SolidoodleDev/press-pcbs-and-firmware/Solidoodle Press PCB's/SD5DA - Press Motherboard PCB/readme.txt

Hi Sam, 

   The SD5 was done is Novarm DipTrace. 

Talk soon 

Matt Stevenson 
RUSHdesign LLC
