SolidoodleDev/press-pcbs-and-firmware/Solidoodle Press PCB's/prelim schematics.jpg

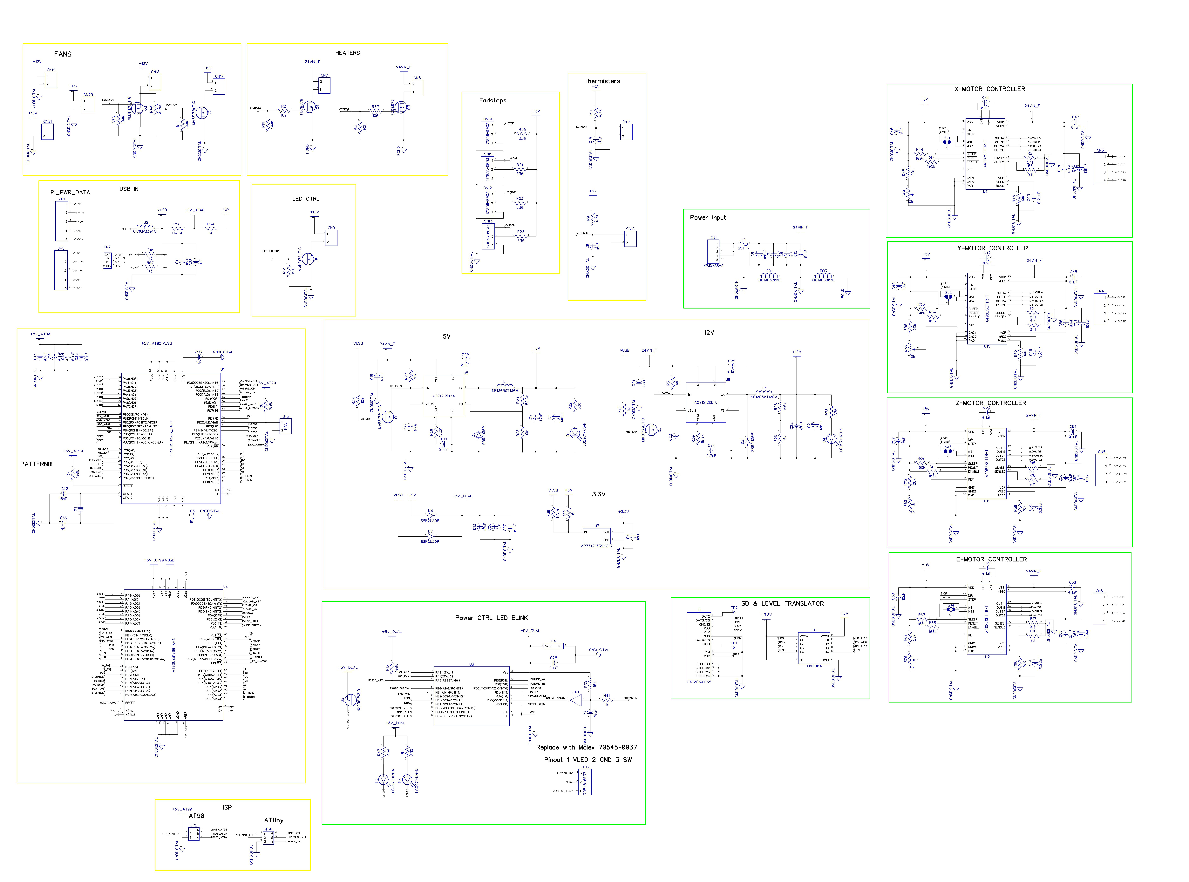
Solidoodle Press PCB's/prelim schematics.jpg
