SolidoodleDev/press-pcbs-and-firmware/Solidoodle Press PCB's/SD5AA - Press Motherboard PCB/image.png

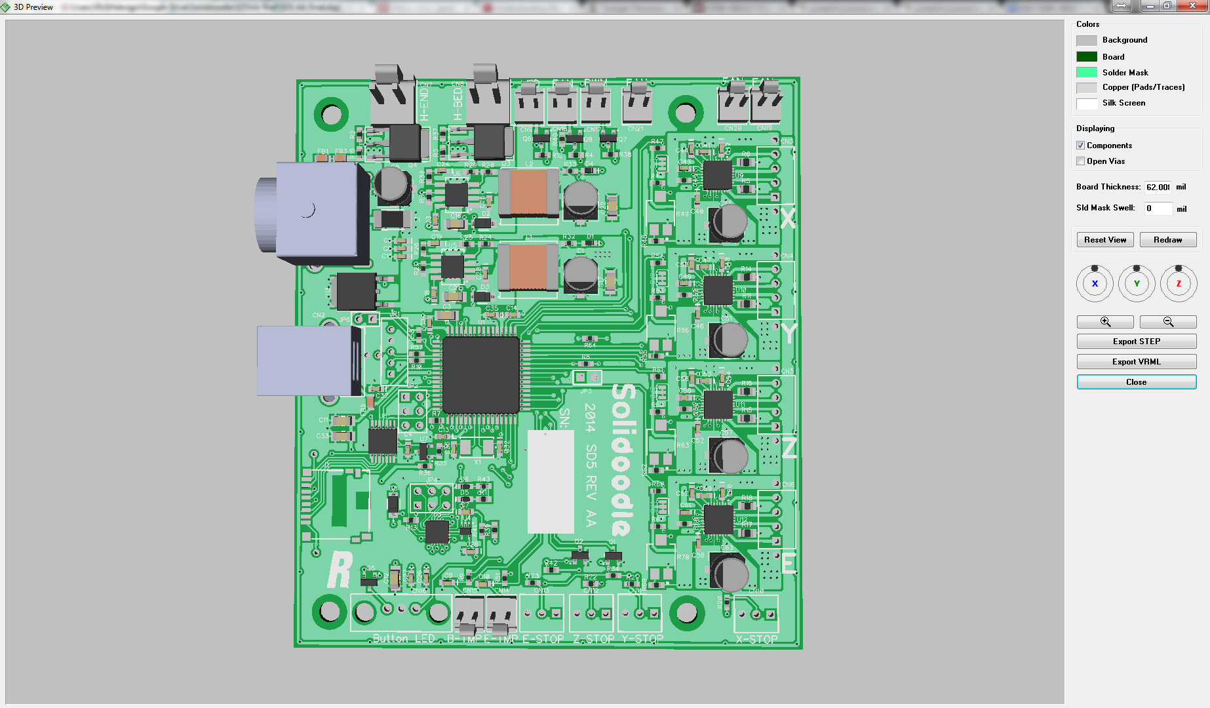
Solidoodle Press PCB's/SD5AA - Press Motherboard PCB/image.png
