SolidoodleDev/press-pcbs-and-firmware/Solidoodle Press PCB's/SD5AA - Press Motherboard PCB/BOM.xls

RefDes | Value | Name | BUILDOPT | Voltage | Tolerance | Circuit
C1 | 100uF | EEE-1VA101XP | 1 |  |  | 5V
C10 | 10uF | CAP_0603 | 1 | 50 | 10.00% | Thermisters
C11 | 10uF | CAP_1206 | 1 | 50 | 10.00% | USB In
C12 | 47uF | CAP_1206 | 1 | 50 | 10.00% | 5V
C13 | 0.1uF | CAP_0603 | 1 | 50 | 10.00% | AT90
C14 | 0.1uF | CAP_0603 | 1 | 50 | 10.00% | AT90
C15 | 0.1uF | CAP_0603 | 1 | 50 | 10.00% | Power input
C16 | 47uF | CAP_1206 | 1 | 50 | 10.00% | 5V
C17 | 47uF | CAP_1206 | 1 | 50 | 10.00% | 5V
C18 | N/A | CAP_0603 | 1 | 50 | 10.00% | 5V
C19 | 2.7nF | CAP_0603 | 1 | 50 | 10.00% | 5V
C2 | 100uF | EEE-1VA101XP | 1 |  |  | 12V
C20 | 0.1uF | CAP_0603 | 1 | 50 | 10.00% | 5V
C21 | 47uF | CAP_1206 | 1 | 50 | 10.00% | 12V
C22 | 47uF | CAP_1206 | 1 | 50 | 10.00% | 12V
C23 | N/A | CAP_0603 | 1 | 50 | 10.00% | 12V
C24 | 2.7nF | CAP_0603 | 1 | 50 | 10.00% | 12V
C25 | 0.1uF | CAP_0603 | 1 | 50 | 10.00% | 12V
C26 | 1uF | CAP_0603 | 1 | 50 | 10.00% | 5V
C27 | 0.1uF | CAP_0603 | 1 | 50 | 10.00% | 5V
C28 | 0.1uF | CAP_0603 | 1 | 50 | 10.00% | Button
C3 | 1uF | CAP_1206 | 1 | 50 | 10.00% | AT90
C32 | 15pF | 06031A150JAT2A | 1 |  |  | AT90
C33 | 1uF | CAP_1206 | 1 | 50 | 10.00% | USB in
C34 | 0.1uF | CAP_0603 | 1 | 50 | 10.00% | AT90
C35 | 0.1uF | CAP_0603 | 1 | 50 | 10.00% | AT90
C36 | 15pF | 06031A150JAT2A | 1 |  |  | AT90
C37 | 1uF | CAP_0603 | 1 | 50 | 10.00% | AT90
C4 | 10uF | CAP_0603 | 3 | 50 | 10.00% | 3.3V
C40 | 10uF | CAP_0603 | 1 | 50 | 10.00% | X motor
C41 | 0.1uF | CAP_0603 | 1 | 50 | 10.00% | X motor
C42 | 0.1uF | CAP_0603 | 1 | 50 | 10.00% | X motor
C43 | 0.22uF | CAP_0603 | 1 | 50 | 10.00% | X motor
C44 | 0.1uF | CAP_0603 | 1 | 50 | 10.00% | X motor
C45 | 100uF | EEE-1VA101XP | 1 |  |  | X motor
C46 | 10uF | CAP_0603 | 1 | 50 | 10.00% | Y motor
C47 | 0.1uF | CAP_0603 | 1 | 50 | 10.00% | Y motor
C48 | 0.1uF | CAP_0603 | 1 | 50 | 10.00% | Y motor
C49 | 0.22uF | CAP_0603 | 1 | 50 | 10.00% | Y motor
C5 | 100uF | EEE-1VA101XP | 1 |  |  | Power input
C50 | 0.1uF | CAP_0603 | 1 | 50 | 10.00% | Y motor
C51 | 100uF | EEE-1VA101XP | 1 |  |  | Y motor
C52 | 10uF | CAP_0603 | 1 | 50 | 10.00% | Z motor
C53 | 0.1uF | CAP_0603 | 1 | 50 | 10.00% | Z motor
C54 | 0.1uF | CAP_0603 | 1 | 50 | 10.00% | Z motor
C55 | 0.22uF | CAP_0603 | 1 | 50 | 10.00% | Z motor
C56 | 0.1uF | CAP_0603 | 1 | 50 | 10.00% | Z motor
C57 | 100uF | EEE-1VA101XP | 1 |  |  | Z motor
C58 | 10uF | CAP_0603 | 1 | 50 | 10.00% | E motor
C59 | 0.1uF | CAP_0603 | 1 | 50 | 10.00% | E motor
C6 | 10uF | CAP_0603 | 1 | 50 | 10.00% | Power input
C60 | 0.1uF | CAP_0603 | 1 | 50 | 10.00% | E motor
C61 | 0.22uF | CAP_0603 | 1 | 50 | 10.00% | E motor
C62 | 0.1uF | CAP_0603 | 1 | 50 | 10.00% | E motor
C63 | 100uF | EEE-1VA101XP | 1 |  |  | E motor
C7 | 10uF | CAP_0603 | 1 | 50 | 10.00% | Button
C8 | 1uF | CAP_0603 | 1 | 50 | 10.00% | Power input
C9 | 10uF | CAP_0603 | 1 | 50 | 10.00% | Thermisters
CN1 | KPJX-3S-S | KPJX-3S/ KPJX-4S | 1 |  |  | Power input
CN10 | 171856-0003 | 1X3 0.1in Friction Lock | 1 |  |  | Endstops
CN11 | 171856-0003 | 1X3 0.1in Friction Lock | 1 |  |  | Endstops
CN12 | 171856-0003 | 1X3 0.1in Friction Lock | 1 |  |  | Endstops
CN13 | 171856-0003 | 1X3 0.1in Friction Lock | 1 |  |  | Endstops
CN14 | 171856-0002 | 1X2 0.1in Friction Lock | 1 |  |  | Thermisters
CN15 | 171856-0002 | 1X2 0.1in Friction Lock | 1 |  |  | Thermisters
CN16 | 70545-0037 | 1X3 0.1in Friction Lock | 1 |  |  | Button
CN17 | 171856-0002 | 1X2 0.1in Friction Lock | 1 |  |  | Fans
CN18 | 171856-0002 | 1X2 0.1in Friction Lock | 1 |  |  | Fans
CN19 | 171856-0002 | 1X2 0.1in Friction Lock | 1 |  |  | Fans
CN2 | AU-Y1007-R | USB-B-TH | 1.3 |  |  | USB in
CN20 | 171856-0002 | 1X2 0.1in Friction Lock | 1 |  |  | Fans
CN21 | 171856-0002 | 1X2 0.1in Friction Lock | 1 |  |  | Fans
CN3 | 71856-0004 | 1X4 0.1in Friction Lock | 1 |  |  | X motor
CN4 | 71856-0004 | 1X4 0.1in Friction Lock | 1 |  |  | Y motor
CN5 | 71856-0004 | 1X4 0.1in Friction Lock | 1 |  |  | Z motor
CN6 | 71856-0004 | 1X4 0.1in Friction Lock | 1 |  |  | E motor
CN7 | 640445-2 | 2PIN HEADER 0.156 | 1 |  |  | Heaters
CN8 | 640445-2 | 2PIN HEADER 0.156 | 1 |  |  | Heaters
CN9 | 171856-0002 | 1X2 0.1in Friction Lock | 1 |  |  | LED ctrl
D1 | LGQ971-KN-N | LED | 1 |  |  | 5V
D2 | SBR2U30P1 | SBR2U30P1 | 1 |  |  | 12V
D3 | SBR2U30P1 | SBR2U30P1 | 1 |  |  | 5V
D4 | LGQ971-KN-N | LED | 1 |  |  | 12V
D5 | LGQ971-KN-N | LED | 1 |  |  | Button
D6 | LGQ971-KN-N | LED | 1 |  |  | Button
D8 | SBR2U30P1 | SBR2U30P1 | 1 |  |  | 5V
F1 | SST 7 | FUSE | 1 |  |  | Power input
FB1 | CIS21P300NE | IND_0805 | 1 | 50 |  | Power input
FB2 | CIS21P300NE | IND_0805 | 1 | 50 |  | USB in
FB3 | CIS21P300NE | IND_0805 | 1 | 50 |  | Power input
J1 | 114-00841-68 | MICROSD | 3 |  |  | SD card
J2 | 440054-5 | CC1X5M 2MM | 1 |  |  | AT90
J3 | 440054-5 | CC1X5M 2MM | 1 |  |  | AT90
J4 | 440054-3 | CC1X3M 2MM | 1 |  |  | AT90
JP1 | 440054-5 | CC1X5M 2MM | 1 |  |  | USB in
JP2 | 67998-406HLF | 2x3 .100in | 1 |  |  | ISP
JP3 | 68602-402HLF | BOOT | 1 |  |  | AT90
JP4 | 67998-406HLF | 2x3 .100in | 1 |  |  | ISP
JP6 | 68602-402HLF |  | 1.3 |  |  | USB in
JP7 | 440054-5 | CC1X5M 2MM | 1.4 |  |  | AT90
L1 | NR10050T100M | Yaiyo Yuden 10050 | 1 |  |  | 5V
L2 | NR10050T100M | Yaiyo Yuden 10050 | 1 |  |  | 12V
Q1 | MMBF170LT1G | MOSFETN | 1 |  |  | 5V
Q2 | MMBF170LT1G | MOSFETN | 1 |  |  | 12V
Q3 | FDD8876 | MOSFET-N TO-252 | 1 |  |  | Heaters
Q4 | FDD8876 | MOSFET-N TO-252 | 1 |  |  | Heaters
Q5 | NX2301P,215 | MOSFETN | 1 |  |  | Button
Q6 | MMBF170LT1G | MOSFETN | 1 |  |  | LED ctrl
Q7 | MMBF170LT1G | MOSFETN | 1 |  |  | Fans
Q8 | MMBF170LT1G | MOSFETN | 1.5 |  |  | Fans
R1 | 330 | RES_0603 | 1 | 50 | 5.00% | Button
R10 | 22 | RES_0603 | 1 | 50 | 5.00% | USB in
R11 | 0.11 | RES_0805 | 1 | 50 | 1.00% | Y motor
R12 | 100K | RES_0603 | 1 | 50 | 5.00% | LED ctrl
R13 | 100k | RES_0603 | 1 | 50 | 5.00% | Button
R14 | 0.11 | RES_0805 | 1 | 50 | 1.00% | Y motor
R15 | 0.11 | RES_0805 | 1 | 50 | 1.00% | Z motor
R16 | 0.11 | RES_0805 | 1 | 50 | 1.00% | Z motor
R17 | 0.11 | RES_0805 | 1 | 50 | 1.00% | E motor
R18 | 0.11 | RES_0805 | 1 | 50 | 1.00% | E motor
R19 | 100K | RES_0603 | 1 | 50 | 5.00% | Heaters
R2 | 100 | RES_0603 | 1 | 50 | 5.00% | Heaters
R20 | 330 | RES_0603 | 1 | 50 | 5.00% | Endstops
R21 | 330 | RES_0603 | 1 | 50 | 5.00% | Endstops
R22 | 330 | RES_0603 | 1 | 50 | 5.00% | Endstops
R23 | 330 | RES_0603 | 1 | 50 | 5.00% | Endstops
R24 | 52.3k | RES_0603 | 1 | 50 | 5.00% | 5V
R25 | 10k | RES_0603 | 1 | 50 | 5.00% | 5V
R26 | 18.2K | RES_0603 | 1 | 50 | 5.00% | 5V
R27 | 10k | RES_0603 | 1 | 50 | 5.00% | 5V
R28 | 140k | RES_0603 | 1 | 50 | 5.00% | 12V
R29 | 10k | RES_0603 | 1 | 50 | 5.00% | 12V
R3 | 100K | RES_0603 | 1 | 50 | 5.00% | Heaters
R30 | 18.2k | RES_0603 | 1 | 50 | 5.00% | 12V
R31 | 10k | RES_0603 | 1 | 50 | 5.00% | 12V
R32 | 330 | RES_0603 | 1 | 50 | 5.00% | 5V
R33 | 330 | RES_0603 | 1 | 50 | 5.00% | 12V
R34 | 10k | RES_0603 | 1 | 50 | 5.00% | 5V
R35 | 0 | RES_0603 | 3 | 50 | 5.00% | 3.3V
R36 | NA 0 | RES_0603 | 3 | 50 | 5.00% | 3.3V
R37 | 100 | RES_0603 | 1 | 50 | 5.00% | Heaters
R38 | 100K | RES_0603 | 1.5 | 50 | 5.00% | Fans
R39 | 10K | RES_0603 | 1 | 50 | 5.00% | Button
R4 | 100K | RES_0603 | 1 | 50 | 5.00% | Fans
R40 | 0 NA | RES_0603 | 1.6 | 50 | 5.00% | Fans
R41 | 1k | RES_0603 | 1 | 50 | 5.00% | Button
R42 | 10k | RES_0603 | 1 | 50 | 5.00% | 12V
R43 | 330 | RES_0603 | 1 | 50 | 5.00% | Button
R44 | 0/DNP | RES_0603 | 0 | 50 | 5.00% | Button
R45 | 10K | RES_0603 | 1 | 50 | 1.00% | X motor
R46 | 100k | RES_0603 | 1 | 50 | 5.00% | X motor
R47 | 100k | RES_0603 | 1 | 50 | 5.00% | X motor
R48 | 20k | RES_0603 | 1 | 50 | 5.00% | X motor
R49 | 10k | ST-4ETB | 1 |  |  | X motor
R5 | 0.11 | RES_0805 | 1 | 50 | 1.00% | X motor
R50 | 0/DNP | RES_0603 | 0 | 50 | 5.00% | Button
R51 | 4.7K | RES_0603 | 1 | 50 | 5.00% | Thermisters
R52 | 10K | RES_0603 | 1 | 50 | 1.00% | Y motor
R53 | 100k | RES_0603 | 1 | 50 | 5.00% | Y motor
R54 | 100k | RES_0603 | 1 | 50 | 5.00% | Y motor
R55 | 20k | RES_0603 | 1 | 50 | 5.00% | Y motor
R56 | 10k | ST-4ETB | 1 |  |  | Y motor
R57 | 22 | RES_0603 | 1 | 50 | 5.00% | USB in
R58 | NA 0 | RES_0603 | 1.4 | 50 | 5.00% | USB in
R59 | 10K | RES_0603 | 1 | 50 | 1.00% | Z motor
R6 | 0.11 | RES_0805 | 1 | 50 | 1.00% | X motor
R60 | 100k | RES_0603 | 1 | 50 | 5.00% | Z motor
R61 | 100k | RES_0603 | 1 | 50 | 5.00% | Z motor
R62 | 20k | RES_0603 | 1 | 50 | 5.00% | Z motor
R63 | 10k | ST-4ETB | 1 |  |  | Z motor
R64 | 0 | RES_0603 | 1 | 50 | 5.00% | USB in
R66 | 10K | RES_0603 | 1 | 50 | 1.00% | E motor
R67 | 100k | RES_0603 | 1 | 50 | 5.00% | E motor
R68 | 100k | RES_0603 | 1 | 50 | 5.00% | E motor
R69 | 20k | RES_0603 | 1 | 50 | 5.00% | E motor
R7 | 100k | RES_0603 | 1 | 50 | 5.00% | AT90
R70 | 10k | ST-4ETB | 1 |  |  | E motor
R8 | 100k | RES_0603 | 1 | 50 | 5.00% | AT90
R9 | 4.7K | RES_0603 | 1 | 50 | 5.00% | Thermisters
SJ1 |  | SOLDERJUMPER_2WAYCONNECTED | 1 |  |  | X motor
SJ2 |  | SOLDERJUMPER_2WAYCONNECTED | 1 |  |  | Y motor
SJ3 |  | SOLDERJUMPER_2WAYCONNECTED | 1 |  |  | Z motor
SJ4 |  | SOLDERJUMPER_2WAYCONNECTED | 1 |  |  | E motor
TP1 |  | TESTPOINT |  |  |  | SD card
TP2 |  | TESTPOINT |  |  |  | SD card
U1 | AT90USB1286 | AT90USB1286_TQFP | 1.1 |  |  | AT90
U10 | A4982SETTR-T | A4982SETTR-T | 1 |  |  | Y motor
U11 | A4982SETTR-T | A4982SETTR-T | 1 |  |  | Z motor
U12 | A4982SETTR-T | A4982SETTR-T | 1 |  |  | E motor
U13 | L78M05CDT-TR | L78M05CDT-TR | 1 |  |  | 5V
U2 | AT90USB1286 | AT90USB1286_QFN | 1.2 |  |  | AT90
U3 | ATTINY2313A-MUR | ATTINY2313_MLF | 1 |  |  | Button
U4 |  | MC74VHC1G14DFT1 | 1 |  |  | Button
U5 | AOZ1212DI/AI | AOZ1212DI/AI | 1 |  |  | 5V
U6 | AOZ1212DI/AI | AOZ1212DI/AI | 1 |  |  | 12V
U7 | AP7313-33SAG-7 | AP7313 | 3 |  |  | 3.3V
U8 | TXB0104 | TXB0104 | 3 |  |  | SD card
U9 | A4982SETTR-T | A4982SETTR-T | 1 |  |  | X motor
X1 | ABM3-16.000MHZ-D2Y-T | ABM3 | 1 |  |  | AT90
