SolidoodleDev/press-pcbs-and-firmware/Solidoodle Press PCB's/SD5BA - Press Motherboard PCB/BUILD BOM BA.xls

Sheet: POP
RefDes | Name | Value | Voltage/Watt | TOL | BUILDOPT | Notes
R35 | RES_0603 | 0 | 1/4W | 1.00% | 3
R64 | RES_0603 | 0 | 1/4W | 1.00% | 1
R11 | RES_0805 | 0.11 | 1/4W | 1.00% | 1
R14 | RES_0805 | 0.11 | 1/4W | 1.00% | 1
R15 | RES_0805 | 0.11 | 1/4W | 1.00% | 1
R16 | RES_0805 | 0.11 | 1/4W | 1.00% | 1
R17 | RES_0805 | 0.11 | 1/4W | 1.00% | 1
R18 | RES_0805 | 0.11 | 1/4W | 1.00% | 1
R5 | RES_0805 | 0.11 | 1/4W | 1.00% | 1
R6 | RES_0805 | 0.11 | 1/4W | 1.00% | 1
R10 | RES_0603 | 22 | 1/8W | 1.00% | 1
R57 | RES_0603 | 22 | 1/8W | 1.00% | 1
R2 | RES_0603 | 100 | 1/8W | 1.00% | 1
R37 | RES_0603 | 100 | 1/8W | 1.00% | 1
R1 | RES_0603 | 330 | 1/8W | 1.00% | 1
R20 | RES_0603 | 330 | 1/8W | 1.00% | 1
R21 | RES_0603 | 330 | 1/8W | 1.00% | 1
R22 | RES_0603 | 330 | 1/8W | 1.00% | 1
R23 | RES_0603 | 330 | 1/8W | 1.00% | 1
R32 | RES_0603 | 330 | 1/8W | 1.00% | 1
R43 | RES_0603 | 330 | 1/8W | 1.00% | 1
R33 | RES_0603 | 420 | 1/8W | 1.00% | 1
C13 | CAP_0603 | 0.1uF | 50V | 10.00% | 1
C14 | CAP_0603 | 0.1uF | 50V | 10.00% | 1
C15 | CAP_0603 | 0.1uF | 50V | 10.00% | 1
C20 | CAP_0603 | 0.1uF | 50V | 10.00% | 1
C25 | CAP_0603 | 0.1uF | 50V | 10.00% | 1
C27 | CAP_0603 | 0.1uF | 50V | 10.00% | 1
C28 | CAP_0603 | 0.1uF | 50V | 10.00% | 1
C34 | CAP_0603 | 0.1uF | 50V | 10.00% | 1
C35 | CAP_0603 | 0.1uF | 50V | 10.00% | 1
C41 | CAP_0603 | 0.1uF | 50V | 10.00% | 1
C42 | CAP_0603 | 0.1uF | 50V | 10.00% | 1
C44 | CAP_0603 | 0.1uF | 50V | 10.00% | 1
C47 | CAP_0603 | 0.1uF | 50V | 10.00% | 1
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
JP4 | 2x3 .100in | 67998-406HLF |  |  | 1
JP6 | 68602-402HLF | 68602-402HLF |  |  | 1.3
JP3 | BOOT | 68602-402HLF |  |  | 1
CN16 | 1X3 0.1in Friction Lock | 70545-0037 |  |  | 1
CN3 | 1X4 0.1in Friction Lock | 71856-0004 |  |  | 1
CN4 | 1X4 0.1in Friction Lock | 71856-0004 |  |  | 1
CN5 | 1X4 0.1in Friction Lock | 71856-0004 |  |  | 1
CN6 | 1X4 0.1in Friction Lock | 71856-0004 |  |  | 1
U10 | A4982SETTR-T | A4982SETTR-T |  |  | 1
U11 | A4982SETTR-T | A4982SETTR-T |  |  | 1
U12 | A4982SETTR-T | A4982SETTR-T |  |  | 1
U9 | A4982SETTR-T | A4982SETTR-T |  |  | 1
X1 | ABM3-16.000MHZ-D2Y-T | ABM3-16.000MHZ-D2Y-T |  |  | 1
U5 | AOZ1212DI/AI | AOZ1212DI/AI |  |  | 1
U6 | AOZ1212DI/AI | AOZ1212DI/AI |  |  | 1
U7 | AP7313-33SAG-7 | AP7313-33SAG-7 |  |  | 3
U2 | AT90USB1286-MU | AT90USB1286-MU |  |  | 1.2
U14 | ATTINY2313_SOIC | ATTINY2313A-MUR |  |  | 1
CN2 | USB-B-TH | AU-Y1007-R |  |  | 1.3
FB1 | IND_0805 | CIS21P300NE |  |  | 1
FB2 | IND_0805 | CIS21P300NE |  |  | 1
FB3 | IND_0805 | CIS21P300NE |  |  | 1
Q3 | MOSFET-N TO-252 | FDD8876 |  |  | 1
Q4 | MOSFET-N TO-252 | FDD8876 |  |  | 1
CN1 | KPJX-3S/ KPJX-4S | KPJX-3S-S |  |  | 1
U13 | L78M05CDT-TR | L78M05CDT-TR |  |  | 1
D1 | LED | LGQ971-KN-N |  |  | 1
D4 | LED | LGQ971-KN-N |  |  | 1
D5 | LED | LGQ971-KN-N |  |  | 1
D6 | LED | LGQ971-KN-N |  |  | 1
U4 | MC74VHC1G14DFT1 | MC74VHC1G14DFT1 |  |  | 1
Q1 | MOSFETN | MMBF170LT1G |  |  | 1
Q2 | MOSFETN | MMBF170LT1G |  |  | 1
Q6 | MOSFETN | MMBF170LT1G |  |  | 1
Q7 | MOSFETN | MMBF170LT1G |  |  | 1
Q8 | MOSFETN | MMBF170LT1G |  |  | 1.5
L1 | Yaiyo Yuden 10050 | NR10050T100M |  |  | 1
L2 | Yaiyo Yuden 10050 | NR10050T100M |  |  | 1
Q5 | MOSFETN | NX2301P,215 |  |  | 1
D2 | SBR2U30P1 | SBR2U30P1 |  |  | 1
D3 | SBR2U30P1 | SBR2U30P1 |  |  | 1
D8 | SBR2U30P1 | SBR2U30P1 |  |  | 1
F1 | FUSE | SST 7 |  |  | 1
J1 | TF Outside welding | TF Outside welding |  |  | 3 | No part number provided by OEM
U8 | TXB0104 | TXB0104 |  |  | 3
R49 | ST4ETB 10K |  |  |  | 1
R56 | ST4ETB 10K |  |  |  | 1
R63 | ST4ETB 10K |  |  |  | 1
R70 | ST4ETB 10K |  |  |  | 1

Sheet: DNP
RefDes | Name | Part | Value | BUILDOPT | Pattern | Notes
J2 | CC1X5M 2MM | Part 1 | 440054-5 | 4 | 440054-5
J3 | CC1X5M 2MM | Part 1 | 440054-5 | 4 | 440054-5
J4 | CC1X3M 2MM | Part 1 | 440054-3 | 4 | 440054-31x3
JP1 | CC1X5M 2MM | Part 1 | 440054-5 | 4 | 440054-5
JP7 | CC1X5M 2MM | Part 1 | 440054-5 | 5 | 440054-5
R36 | RES_0603 | Part 1 | NA 0 | 5 | RES_0603
R40 | RES_0603 | Part 1 | 0 NA | 5 | RES_0603
R44 | RES_0603 | Part 1 | 0/DNP | 5 | RES_0603 | On BA Silk Swapped with R13
R50 | RES_0603 | Part 1 | 0/DNP | 5 | RES_0603
R58 | RES_0603 | Part 1 | NA 0 | 5 | RES_0603
U3 | ATTINY2313_MLF | Part 1 | ATTINY2313A-MUR | 5 | QFN-20/4x4x0.5
U1 | AT90USB1286_TQFP | Part 1 | AT90USB1286 | 6 | QFP-64/16x16x0.8
SJ1 | SOLDERJUMPER_2WAYCONNECTED | Part 1 |  |  |  | 1 | SJ_3_CONNECTED
SJ2 | SOLDERJUMPER_2WAYCONNECTED | Part 1 |  |  |  | 1 | SJ_3_CONNECTED
SJ3 | SOLDERJUMPER_2WAYCONNECTED | Part 1 |  |  |  | 1 | SJ_3_CONNECTED
SJ4 | SOLDERJUMPER_2WAYCONNECTED | Part 1 |  |  |  | 1 | SJ_3_CONNECTED
