SolidoodleDev/press-pcbs-and-firmware/Solidoodle Press PCB's/SD5BA - Press Motherboard PCB/MOTHERBOARD BOM-20131224.xls

AMI P/N | MFG | MFG P/N | QTY | REF DES
PRINTBOARD-PC | PCB,6 UP,LEADED ENIG | 1 | 1 | BOARD
Mfgrs: | IMAGINEERING(LF) | [PRINTBOARD-PC](LF)
SOL-00065-000 | CAP,15PF,0603 | 2 | 2 | C38,C39
Mfgrs: | AVX(LF) | [06031A150JAT2A](LF)
 | JARO(LF) | [CC0603CG150JT100PR](
 | MOUSER(LF) | [581-06031A150J](LF)
SOL-00041-000 | IND,POWER 47UH 1.25A SMD | 1 | 1 | L1
Mfgrs: | BOURNS(LF) | [SDR1006-470KL](LF)
SOL-00036-000 | CAP,ALUM,100uF 20%,35V,SMD | 5 | 5 | C6,C7,C16,C18,C23
Mfgrs: | PANASONIC(LF) | [EEE-1VA101XP](LF)
SOL-00060-000 | IC,VLT LVL TRNSLT,14TSSOP | 1 | 1 | U8
Mfgrs: | T.I(LF) | [TXB0104PWR](LF)
SOL-00064-000 | xtal,16MHz 18pF 30ppm -40C | +85 1 | 1 | X1
Mfgrs: | ABRACON(LF) | [ABM3-16.000MHZ-D2Y-T
 | MOUSER(LF) | [815-ABM3-16-D2Y-T](L
SOL-00048-000 | RES 5.6K 1/8W 5% 0805 | 1 | 1 | R37
Mfgrs: | PANASONIC(LF) | [ERJ-6GEYJ562V](LF)
SOL-00057-000 | IC,DRV,MTRSTEP,24-TSSOP | 4 | 4 | U2,U3,U4,U5
Mfgrs: | ALLEGRO(LF) | [A4982SLPTR-T](LF)
SOL-00037-000 | DIO,40V 1A,SMA | 1 | 1 | D1
Mfgrs: | DIODES INC(LF) | [B140-13-F](LF)
SOL-00050-000 | POT,TRIM,10K OHM 0.25W SMD | 4 | 4 | R5,R15,R23,R29
Mfgrs: | BOURNS(LF) | [3314G-1-103E](LF)
SOL-00046-000 | RES 1.0K 1/8W 5% 0805 | 1 | 1 | R38
Mfgrs: | PANASONIC(LF) | [ERJ-6GEYJ102V](LF)
SOL-00033-000 | CAP,1UF,10%,16V,X7R,0805 | 2 | 2 | C11,C12
Mfgrs: | MURATA(LF) | [GRM21BR71C105KA01L](
SOL-00052-000 | RES 22 OHM 1/8W 5% 0805 | 2 | 2 | R7,R8
Mfgrs: | PANASONIC(LF) | [ERJ-6GEYJ220V](LF)
SOL-00045-000 | RES,0.1 OHM,1%,1/8W,0805 | 8 | 8 | R16,R17,R18,R19,R24,R25,R30,R31
Mfgrs: | BOURNS(LF) | [CRL0805-FW-R100ELF](
SOL-00031-000 | CAP,0.1UF,10%,25V,X7R,0805 | 17 | 17 | C3,C4,C5,C13,C14,C17,C21,C22,C26,C27,C28,C31,C33,C34,C35,C36,C37
Mfgrs: | VISHAY(LF) | [VJ0805Y104KXXMT](LF)
 | VISHAY.(LF) | [VJ0805Y104KXXAC](LF)
SOL-00049-000 | RES 10K 1/8W 5% 0805 | 4 | 4 | R2,R20,R26,R32
Mfgrs: | PANASONIC(LF) | [ERJ-6GEYJ103V](LF)
SOL-00053-000 | RES 100 OHM 1/8W 5% 0805 | 2 | 2 | R11,R36
Mfgrs: | PANASONIC(LF) | [ERJ-6GEYJ101V](LF)
SOL-00044-000 | MOSFET N-CH 30V 78A SOT-23 | 1 | 1 | Q3
Mfgrs: | INTERNATIONAL REC(LF) | [IRLML2060TRPBF](LF)
SOL-00051-000 | RES 20K 1/8W 5% 0805 | 4 | 4 | R39,R40,R41,R42
Mfgrs: | PANASONIC(LF) | [ERJ-6GEYJ203V](LF)
SOL-00034-000 | CAP,10UF,10%,16V,X5R,0805 | 7 | 7 | C9,C10,C15,C20,C25,C30,C32
Mfgrs: | AVX(LF) | [0805YD106KAT2A](LF)
 | MOUSER(LF) | 581-[0805YD106K](LF)
SOL-00054-000 | RES 100K 1/8W 5% 0805 | 13 | 13 | R3,R4,R6,R12,R13,R14,R21,R22,R27,R28,R33,R34,R35
Mfgrs: | PANASONIC(LF) | [ERJ-6GEYJ104V](LF)
SOL-00032-000 | CAP,0.22UF,20%,16V,X7R,080 | 5 5 | 5 | C2,C8,C19,C24,C29
Mfgrs: | MOUSER(LF) | 77-[VJ0805Y224MXJTBC]
 | VISHAY(LF) | [VJ0805Y224MXJTW1BC](
 | VISHAY.(LF) | [VJ0805Y224KXJMT](LF)
 | VISHAY.(LF)(ALT) | [VJ0805Y224KXJTW1BC](
SOL-00047-000 | RES 4.7K 1/8W 5% 0805 | 2 | 2 | R9,R10
Mfgrs: | PANASONIC(LF) | [ERJ-6GEYJ472V](LF)
SOL-00042-000 | LED,ALINGAP GRN CLEAR 0805 | 1 | 1 | LED2
Mfgrs: | DIALIGHT(LF) | [598-8170-107F](LF)
SOL-00058-000 | IC REG LDO 3.3V .15A SOT23 | 1 | 1 | U7
Mfgrs: | DIODES INC(LF) | [AP7313-33SAG-7](LF)
SOL-00055-000 | RES 330 OHM 1/8W 5% 0805 | 1 | 1 | R1
Mfgrs: | PANASONIC(LF) | [ERJ-6GEYJ331V](LF)
SOL-00035-000 | CAP,22UF,10%,16V,X5R,0805 | 1 | 1 | C1
Mfgrs: | TDK(LF) | [C2012X5R1C226KT](LF)
SOL-00059-000 | IC REG BUCK ADJ 0.3A TSOT2 | 3-6 1 | 1 | U1
Mfgrs: | NATIONAL SEMI(LF) | [LM2841XMK-ADJL/NOPB]
SOL-00038-PRG | IC,USB 128K FLASH 16 MHz, | 1 | 1 | U6
 | TQFP-64,PROGRAMMED
Mfgrs: | ATMEL(LF) | [AT90USB1286-AU](LF)
SOL-00056-000 | SWTCH,TCT,SPST-NO 0.05A 32 | V, 1 | 1 | S1
 | SMD
Mfgrs: | C&K(LF) | [KSC351GLFS](LF)
SOL-00039-000 | CONN MINI MICRO-SD 8PIN PC | B 1 | 1 | J1
Mfgrs: | AMPHENOL(LF) | [114-00841-68](LF)
SOL-00011-000 | CONN HDR RTANG 4POS .100 T | IN 4 | 4 | X-MOT,Y-MOT,Z-MOT,E-MOT
Mfgrs: | MOUSER(LF) | [571-6404554](LF)
 | TE/TYCO(LF) | [640455-4](LF)
SOL-00066-000 | CONN USB TYPE B R/A BLACK | 1 | 1 | X2
Mfgrs: | ON SHORE(LF) | [USB-B1HSB6](LF)
SOL-00063-000 | CON,PWR JACK 2.5X5.5MM PCB | 10A 1 | 1 | PWR
Mfgrs: | CUI INC(LF) | [PJ-080BH](LF)
SOL-00010-000 | CONN HDR RTANG 3POS .100 T | IN 3 | 3 | X-STOP,Y-STOP.Z-STOP
Mfgrs: | MOUSER(LF) | [571-6404553](LF)
 | TE/TYCO(LF) | [640455-3](LF)
SOL-00009-000 | CONN HDR RTANG 2POS .100 T | IN 4 | 4 | JP18,JP19,T-BED-1,+2
Mfgrs: | MOUSER(LF) | [571-6404552](LF)
 | TE/TYCO(LF) | [640455-2](LF)
SOL-00067-000 | CONN HEADER VERT 2POS .100 | TIN 2 | 2 | HOTBED,EXTRUDER
Mfgrs: | DIGIKEY(LF) | [A19423-ND](LF)
 | TE/TYCO(LF) | [640454-2](LF)
SOL-00012-000 | HDR,M,2.54MM,6 POS,2ROW | 1 | 1 | ICSP
Mfgrs: | FCI(LF) | [78548-406HLF](LF)
 | MOUSER(LF) | [649-78548-406HLF](LF
SOL-00043-000 | MOSFET N-CH 30V 78A TO220A | B 2 | 2 | Q1,Q2
 | PFM:TRIM ON G-3
 | ADD KAPTON AROUND SILVER O | N 1 OF PARTS
Mfgrs: | INTERNATIONAL REC(LF) | [IRLB8743PBF](LF)
SOL-00029-000 | CON,HDR,2 PIN,0.1 INCH | 1 | 1 | BOOT
Mfgrs: | FCI(LF) | [93287-202HLF](LF)
 | MOUSER(LF) | [649-68001-102H]
 | SOLIDOODLE/CONSIGNED(LF) | MATCH TO DESCRIPTION(
