SolidoodleDev/press-pcbs-and-firmware/Solidoodle Press PCB's/SD5BA - Press Motherboard PCB/Solidoodle Press PCB BOM REV-BA v1.2 12-Sep-2014.x.xls

Sheet: POP
Solidoodle Press PCB REV-BA BOM v1.2
Solidoodle LLC
Proprietary Information - Do not disclose
No substitute components may be used without prior written authorization from Solidoodle
Last Date Modified: 12 Sep 2014
RefDes | Name | Value | BUILDOPT | Notes
C1 | EEE-1VA101XP | 100uF | 1
C10 | CAP_0603 | 10uF | 1
C11 | CAP_1206 | 10uF | 1
C12 | CAP_1206 | 47uF | 1
C13 | CAP_0603 | 0.1uF | 1
C14 | CAP_0603 | 0.1uF | 1
C15 | CAP_0603 | 0.1uF | 1
C16 | CAP_1206 | 47uF | 1
C17 | CAP_1206 | 47uF | 1
C18 | CAP_0603 | 1uF | 1
C19 | CAP_0603 | 2.7nF | 1
C2 | EEE-1VA101XP | 100uF | 1
C20 | CAP_0603 | 0.1uF | 1
C21 | CAP_1206 | 47uF | 1
C22 | CAP_1206 | 47uF | 1
C23 | CAP_0603 | 1uF | 1
C24 | CAP_0603 | 2.7nF | 1
C25 | CAP_0603 | 0.1uF | 1
C26 | CAP_0603 | 1uF | 1
C27 | CAP_0603 | 0.1uF | 1
C28 | CAP_0603 | 0.1uF | 1
C3 | CAP_1206 | 1uF | 1
C32 | 06031A150JAT2A | 15pF | 1
C33 | CAP_1206 | 1uF | 1
C34 | CAP_0603 | 0.1uF | 1
C35 | CAP_0603 | 0.1uF | 1
C36 | 06031A150JAT2A | 15pF | 1
C37 | CAP_0603 | 1uF | 1
C4 | CAP_0603 | 10uF | 2
C40 | CAP_0603 | 10uF | 1
C41 | CAP_0603 | 0.1uF | 1
C42 | CAP_0603 | 0.1uF | 1
C43 | CAP_0603 | 0.22uF | 1
C44 | CAP_0603 | 0.1uF | 1
C45 | EEE-1VA101XP | 100uF | 1
C46 | CAP_0603 | 10uF | 1
C47 | CAP_0603 | 0.1uF | 1
C48 | CAP_0603 | 0.1uF | 1
C49 | CAP_0603 | 0.22uF | 1
C5 | EEE-1VA101XP | 100uF | 1
C50 | CAP_0603 | 0.1uF | 1
C51 | EEE-1VA101XP | 100uF | 1
C52 | CAP_0603 | 10uF | 1
C53 | CAP_0603 | 0.1uF | 1
C54 | CAP_0603 | 0.1uF | 1
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
U14 | ATTINY2313_SOIC | ATTINY2313A-MUR | 1.3
U2 | AT90USB1286_QFN | AT90USB1286 | 1.2
U4 | MC74VHC1G14DFT1 |  | 1
U5 | AOZ1212DI/AI | AOZ1212DI/AI | 1
U6 | AOZ1212DI/AI | AOZ1212DI/AI | 1
U7 | AP7313 | AP7313-33SAG-7 | 2
U8 | TXB0104 | TXB0104 | 2
U9 | A4982SETTR-T | A4982SETTR-T | 1
X1 | ABM3 | ABM3-16.000MHZ-D2Y-T | 1

Sheet: DNP
0
0
0
0
0
RefDes | Name | Value | BUILDOPT | Notes
J2 | CC1X5M 2MM | 440054-5 | 3
J3 | CC1X5M 2MM | 440054-5 | 3
J4 | CC1X3M 2MM | 440054-3 | 3
JP1 | CC1X5M 2MM | 440054-5 | 1.6
JP7 | CC1X5M 2MM | 440054-5 | 6
R36 | RES_0603 | 0 | 7
R40 | RES_0603 | 0 | 1.8
R44 | RES_0603 | 0 | 5 | On BA: silk swapped with R13
R50 | RES_0603 | 0 | 5
R58 | RES_0603 | 0 | 4
U1 | AT90USB1286_TQFP | ATTINY2313A-MUR | 1.1
U3 | ATTINY2313_MLF | AT90USB1286 | 1.4

Sheet: Version History
Version History
v1.1 | 11 Sep 2014 | RD | Original version Removed parts not used Fixed missing/incorrect values for C17, C18, C23, C37
v1.2 | 12 Sep 2014 | RD | Merged Matt's edits Added header Removed pattern column Edited build options Separated parts not populated to separate sheet Added version history and build option sheets

Sheet: Build Options
Build Options
1 | base option, must be selected
1.1 | AT90 TQFP package
1.2 | AT90 QFN package
1.3 | ATtiny SOIC package
1.4 | ATtiny MLF package
1.5 | USB from CN2
1.6 | USB from JP1
1.7 | CN18 is on PWM
1.8 | CN18 is always on
2 | microSD card reader
3 | headers for extra I/O
4 | USB power always on
5 | UART between AT90 and ATtiny
6 | Raspberry Pi header
7 | 3.3V regulator powered by VUSB
