SolidoodleDev/press-pcbs-and-firmware/Solidoodle Press PCB's/SD5BA - Press Motherboard PCB/Solidoodle Press PCB BOM REV-BA v2.0 15-Sep-2014.x.xls

Sheet: POP
Solidoodle Press PCB REV-BA BOM v2.0
Solidoodle LLC
Proprietary Information - Do not disclose
No substitute components may be used without prior written authorization from Solidoodle
Last Date Modified: 15 Sep 2014
Name | Value | Rating | Tolerance | QTY | RefDes
EEE-1VA101XP | 100uF |  |  | 7 | C1 | C2 | C5 | C45 | C51 | C57 | C63
CAP_0603 | 10uF | 25V | 10.00% | 9 | C4 | C6 | C7 | C9 | C10 | C40 | C46 | C52 | C58
CAP_1206 | 10uF | 50V | 10.00% | 1 | C11
CAP_1206 | 47uF | 35V | 10.00% | 5 | C12 | C16 | C17 | C21 | C22
CAP_0603 | 0.1uF | 50V | 10.00% | 21 | C13 | C14 | C15 | C20 | C25 | C27 | C28 | C34 | C35 | C41 | C42 | C44 | C47 | C48 | C50 | C53 | C54 | C56 | C59 | C60 | C62
CAP_0603 | 1uF | 50V | 10.00% | 5 | C8 | C18 | C23 | C26 | C37
CAP_0603 | 2.7nF | 50V | 10.00% | 2 | C19 | C24
CAP_1206 | 1uF | 50V | 10.00% | 2 | C3 | C33
06031A150JAT2A | 15pF | 50V | 10.00% | 2 | C32 | C36
CAP_0603 | 0.22uF | 50V | 10.00% | 4 | C43 | C49 | C55 | C61
KPJX-3S/ KPJX-4S | KPJX-3S-S |  |  | 1 | CN1
1X3 0.1in Friction Lock | 171856-0003 |  |  | 4 | CN10 | CN11 | CN12 | CN13
1X2 0.1in Friction Lock | 171856-0002 |  |  | 8 | CN9 | CN14 | CN15 | CN17 | CN18 | CN19 | CN20 | CN21
1X3 0.1in Friction Lock | 70545-0037 |  |  | 1 | CN16
USB-B-TH | AU-Y1007-R |  |  | 1 | CN2
1X4 0.1in Friction Lock | 71856-0004 |  |  | 4 | CN3 | CN4 | CN5 | CN6
2PIN HEADER 0.156 | 640445-2 |  |  | 2 | CN7 | CN8
LED | LGQ971-KN-N |  |  | 4 | D1 | D4 | D5 | D6
SBR2U30P1 | SBR2U30P1 |  |  | 3 | D2 | D3 | D8
FUSE | SST 7 |  |  | 1 | F1
IND_0805 | CIS21P300NE |  |  | 3 | FB1 | FB2 | FB3
TF Outside welding | TF Outside welding |  |  | 1 | J1
CC1X5M 2MM | 440054-5 |  |  | 3 | J2 | J3 | JP1
CC1X3M 2MM | 440054-3 |  |  | 1 | J4
2x3 .100in | 67998-406HLF |  |  | 2 | JP2 | JP4
1x2 .100in | 68602-402HLF |  |  | 2 | JP3 | JP6
CC1X5M 2MM | 440054-5 |  |  | 1 | JP7
Yaiyo Yuden 10050 | NR10050T100M |  |  | 2 | L1 | L2
MOSFETN | MMBF170LT1G |  |  | 5 | Q1 | Q2 | Q6 | Q7 | Q8
MOSFET-N TO-252 | FDD8876 |  |  | 2 | Q3 | Q4
MOSFETN | NX2301P,215 |  |  | 1 | Q5
RES_0603 | 330 | 1/8W | 1.00% | 7 | R1 | R20 | R21 | R22 | R23 | R32 | R43
RES_0603 | 22 | 1/8W | 1.00% | 2 | R10 | R57
RES_0805 | 0.11 | 1/4W | 1.00% | 8 | R5 | R6 | R11 | R14 | R15 | R16 | R17 | R18
RES_0603 | 100k | 1/8W | 1.00% | 16 | R3 | R4 | R7 | R8 | R12 | R13 | R19 | R38 | R46 | R47 | R53 | R54 | R60 | R61 | R67 | R68
RES_0603 | 100 | 1/8W | 1.00% | 2 | R2 | R37
RES_0603 | 52.3k | 1/8W | 1.00% | 1 | R24
RES_0603 | 10k | 1/8W | 1.00% | 11 | R25 | R27 | R29 | R34 | R39 | R42 | R45 | R49 | R52 | R59 | R66
RES_0603 | 18.2k | 1/8W | 1.00% | 2 | R26 | R30
RES_0603 | 140k | 1/8W | 1.00% | 1 | R28
RES_0603 | 420 | 1/8W | 1.00% | 1 | R33
RES_0603 | 0 | 1/4W | 1.00% | 2 | R35 | R64
RES_0603 | 1k | 1/8W | 1.00% | 1 | R41
RES_0603 | 20k | 1/8W | 1.00% | 4 | R48 | R55 | R62 | R69
ST-4ETB | 10k |  |  | 4 | R49 | R56 | R63 | R70
RES_0603 | 4.7k | 1/8W | 1.00% | 2 | R9 | R51
SOLDERJUMPER_2WAYCONNECTED |  |  |  | 4 | SJ1 | SJ2 | SJ3 | SJ4
A4982SETTR-T | A4982SETTR-T |  |  | 4 | U9 | U10 | U11 | U12
L78M05CDT-TR | L78M05CDT-TR |  |  | 1 | U13
ATTINY2313_SOIC | ATTINY2313A-MUR |  |  | 1 | U14
AT90USB1286_QFN | AT90USB1286 |  |  | 1 | U2
MC74VHC1G14DFT1 |  |  |  | 1 | U4
AOZ1212DI/AI | AOZ1212DI/AI |  |  | 2 | U5 | U6
AP7313 | AP7313-33SAG-7 |  |  | 1 | U7
TXB0104 | TXB0104 |  |  | 1 | U8
ABM3 | ABM3-16.000MHZ-D2Y-T |  |  | 1 | X1

Sheet: Version History
Version History
v1.1 | 11 Sep 2014 | RD | Original version Removed parts not used Fixed missing/incorrect values for C17, C18, C23, C37
v1.2 | 12 Sep 2014 | RD | Merged Matt's edits Added header Removed pattern column Edited build options Separated parts not populated to separate sheet Added version history and build option sheets
v1.3 | 15 Sep 2014 | RD | Added voltage/wattage and tolerance columns Edited build options
v2.0 | 15 Sep 2014 | RD | Changed to Kenvox format Listed all RefDes for each part Removed DNP and Build Options sheets
