SolidoodleDev/press-pcbs-and-firmware/Solidoodle Press Firmware/ATTiny2313/Press firmware instructions (ATtiny).docx

1. Connect USBtiny to JP4 so that the wiring comes from the edge of the board with the thermistors and limit switches.
2. Make sure USBtiny has jumper connected to pass 5V USB power to the board, if not, connect power supply and fully power on board.
3. Run “SolidoodlePress_ATtiny_upload.cmd”
