SolidoodleDev/press-pcbs-and-firmware/Solidoodle Press PCB's/LED button PCB/Schematic Prints.PDF

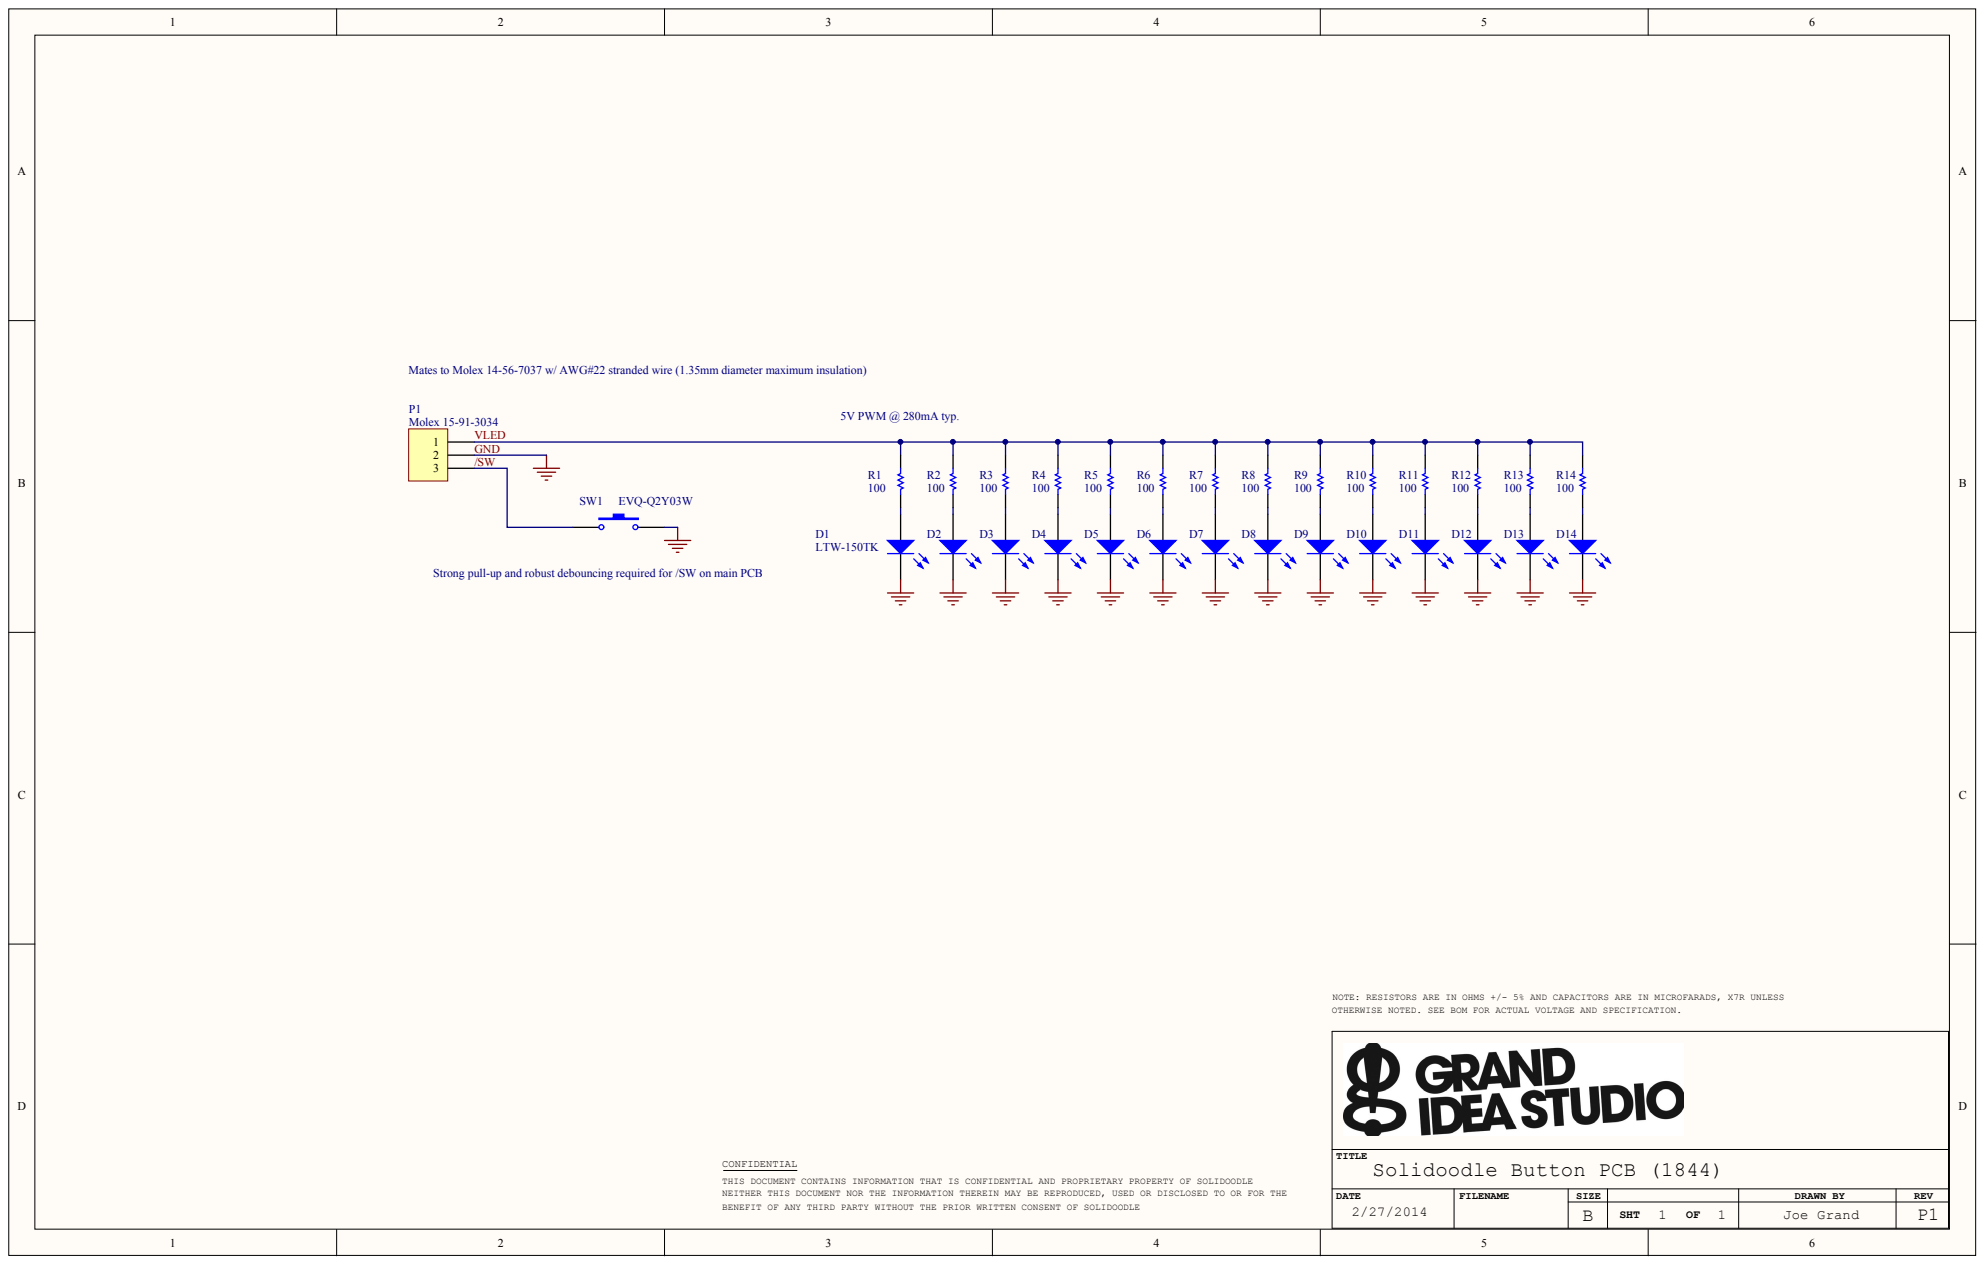
[picture p4: page 1]

l-up and robust debouncing required for

NOTE: RESISTORS ARE IN OHMS +/- 5% AND CAPACITORS ARE IN MICROFARADS, X7R UNLESS

THIS DOCUMENT CONTAINS INFORMATION THAT IS CONFIDENTIAL AND PROPRIETARY PROPERTY OF SOLIDOODLE
NEITHER THIS DOCUMENT NOR THE INFORMATION THEREIN MAY BE REPRODUCED, USED OR DISCLOSED TO OR FOR THE
BENEFIT OF ANY THIRD PARTY WITHOUT THE PRIOR WRITTEN CONSENT OF SOLIDOODLE

DATE | FILENAME | SIZE | | DRAWN BY | REV

SHT OF 1 | J o e G r a n d | P1
