SolidoodleDev/press-pcbs-and-firmware/Solidoodle Press PCB's/SD5AA - Press Motherboard PCB/SD5 AA Final IO UPDATE PG2.pdf

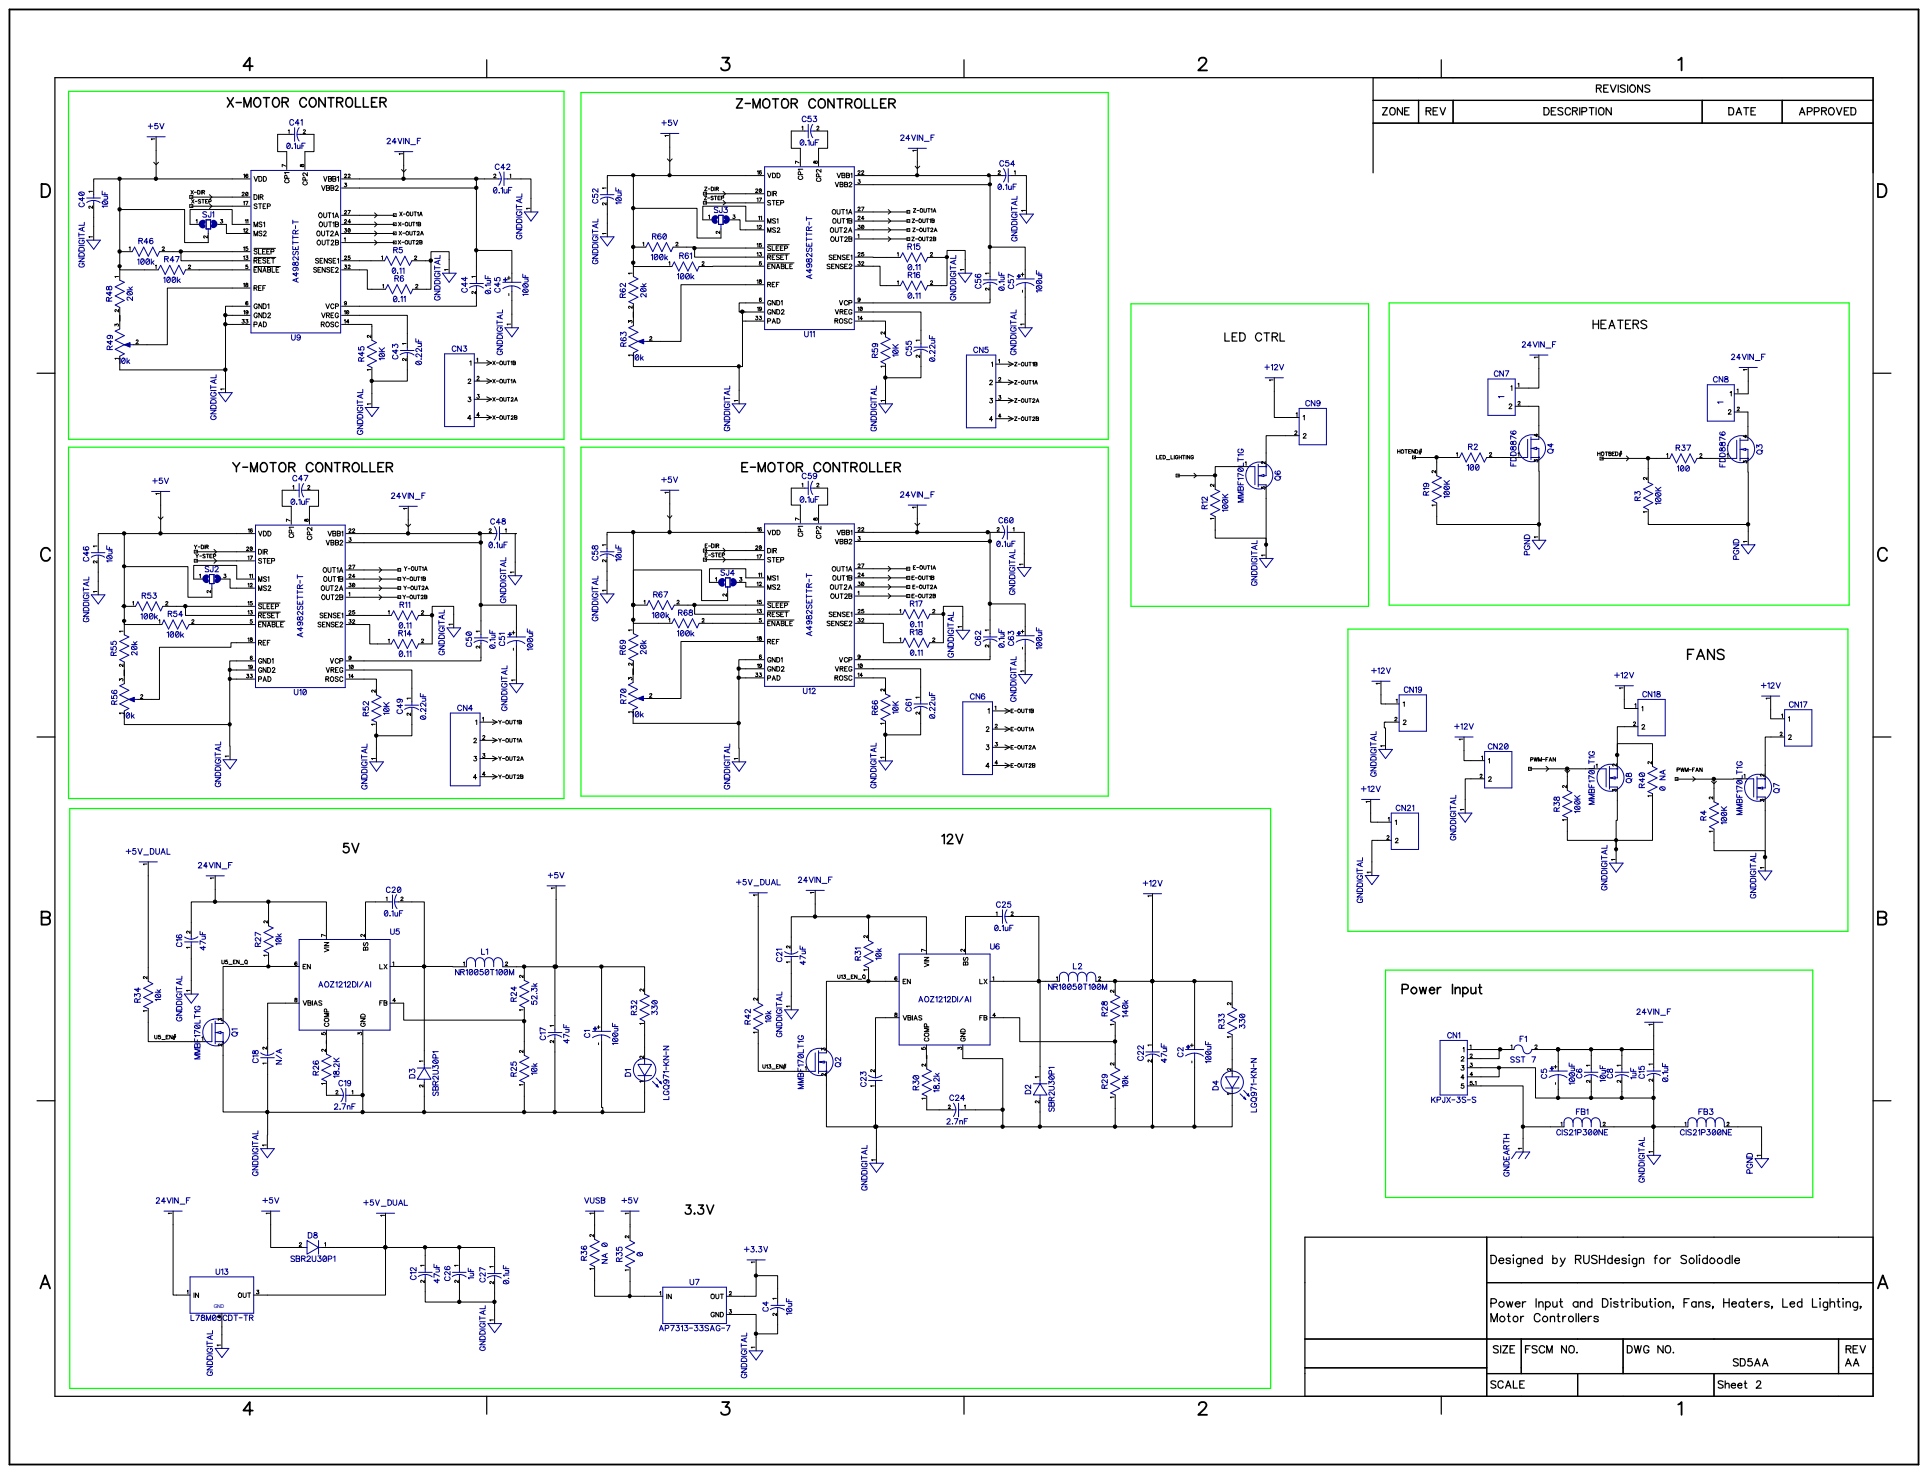
[picture p5: page 1]
GND
