SolidoodleDev/press-pcbs-and-firmware/Solidoodle Press PCB's/SD5DA - Press Motherboard PCB/SD5 DA.dch.pdf

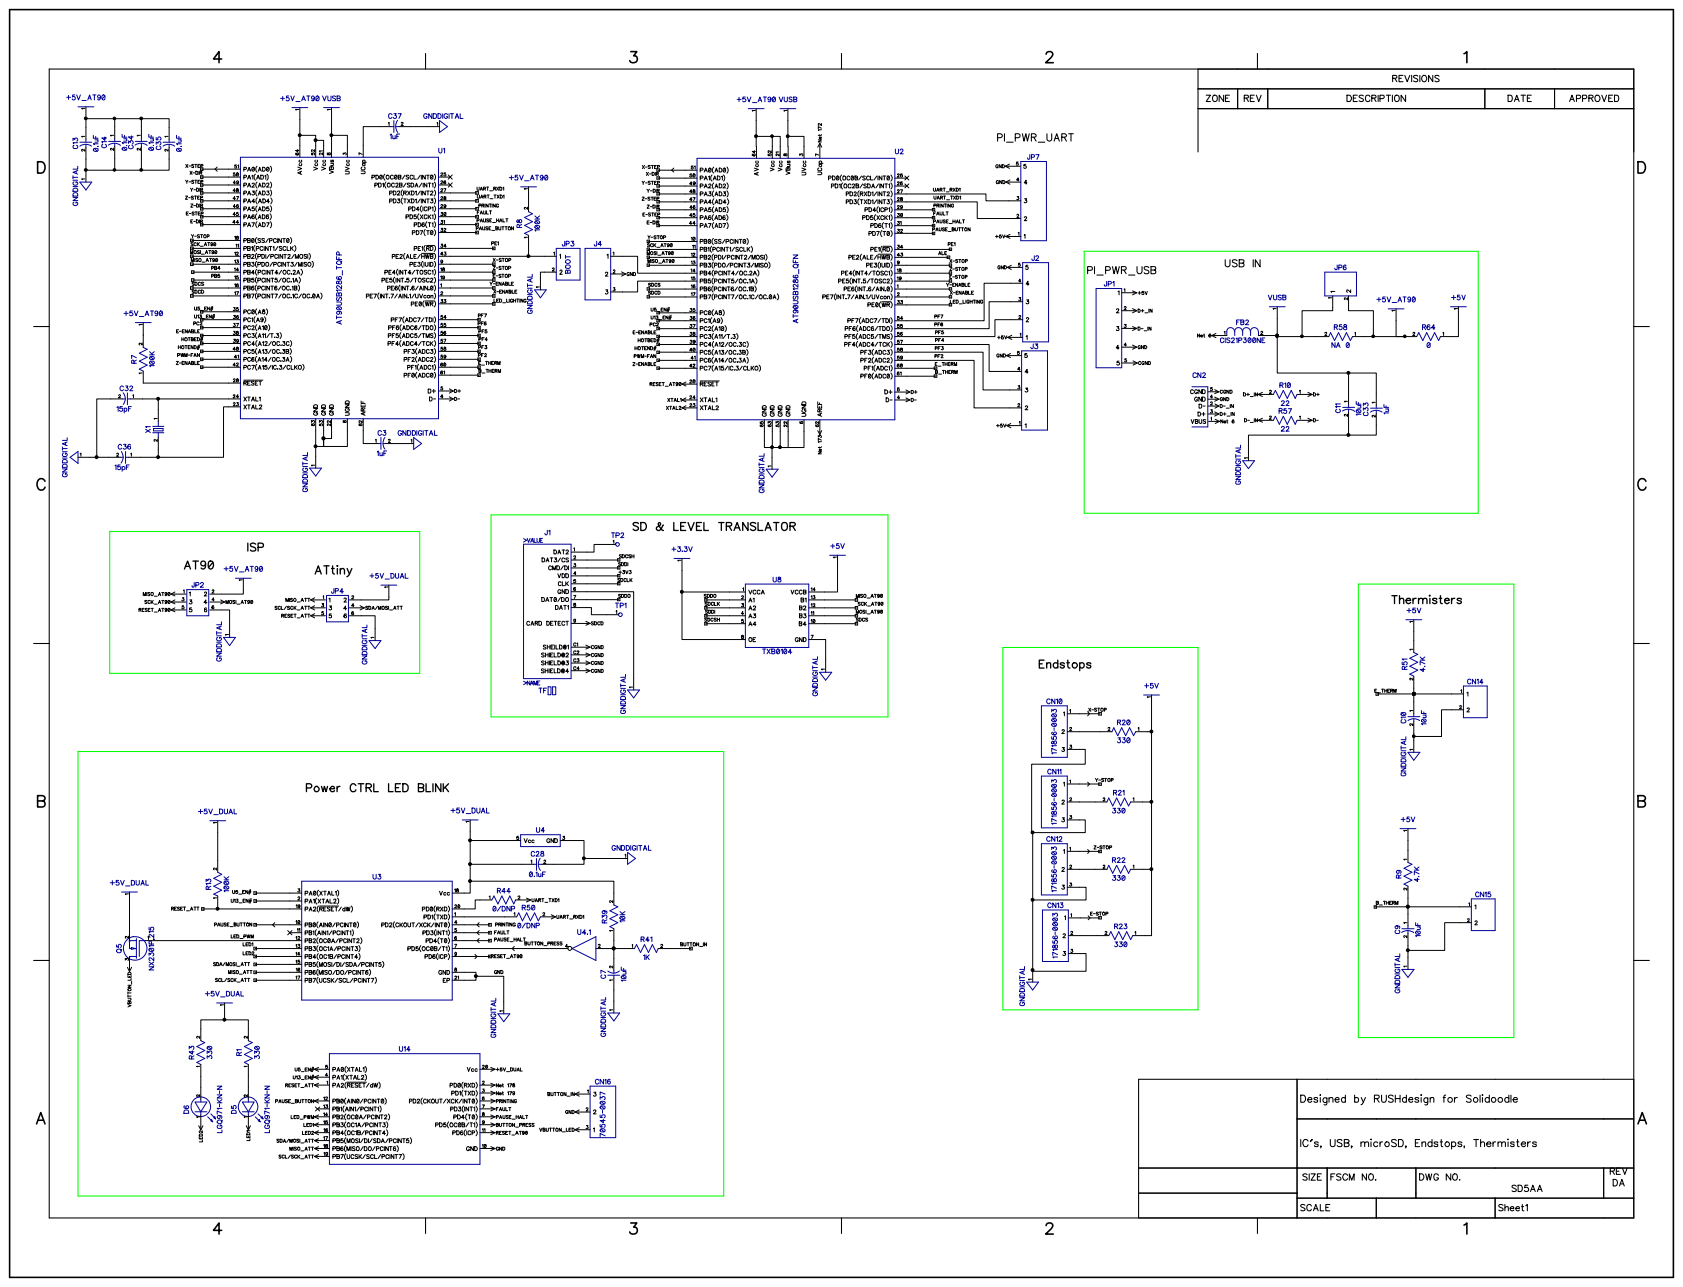
[picture p6: page 1]

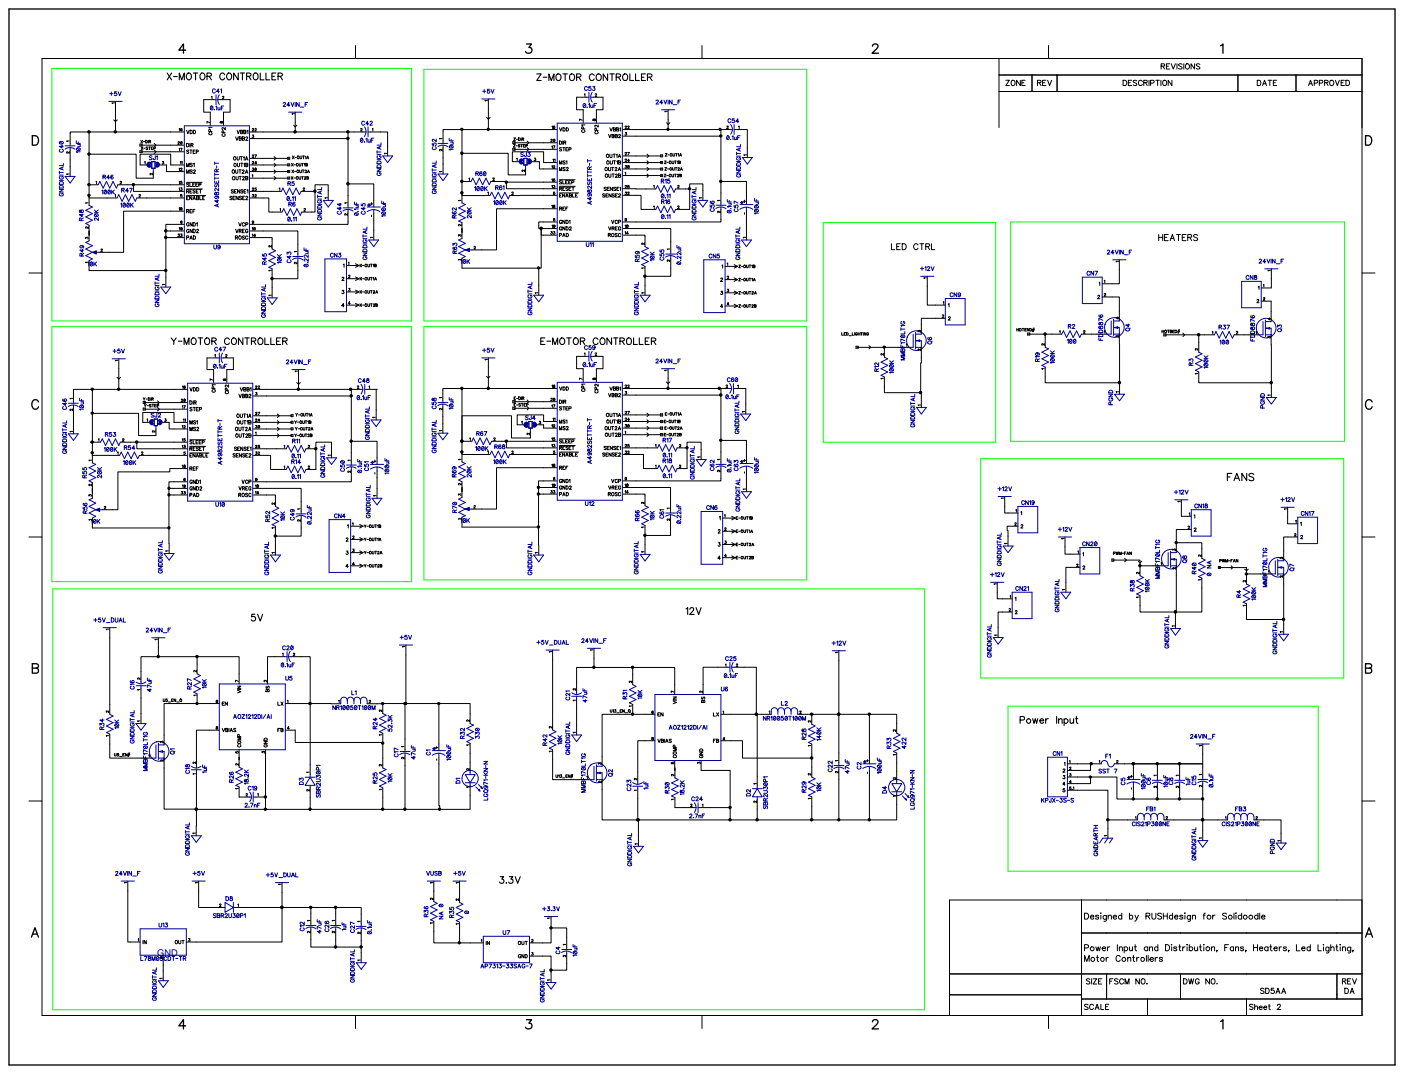
[picture p7: page 2]
GND

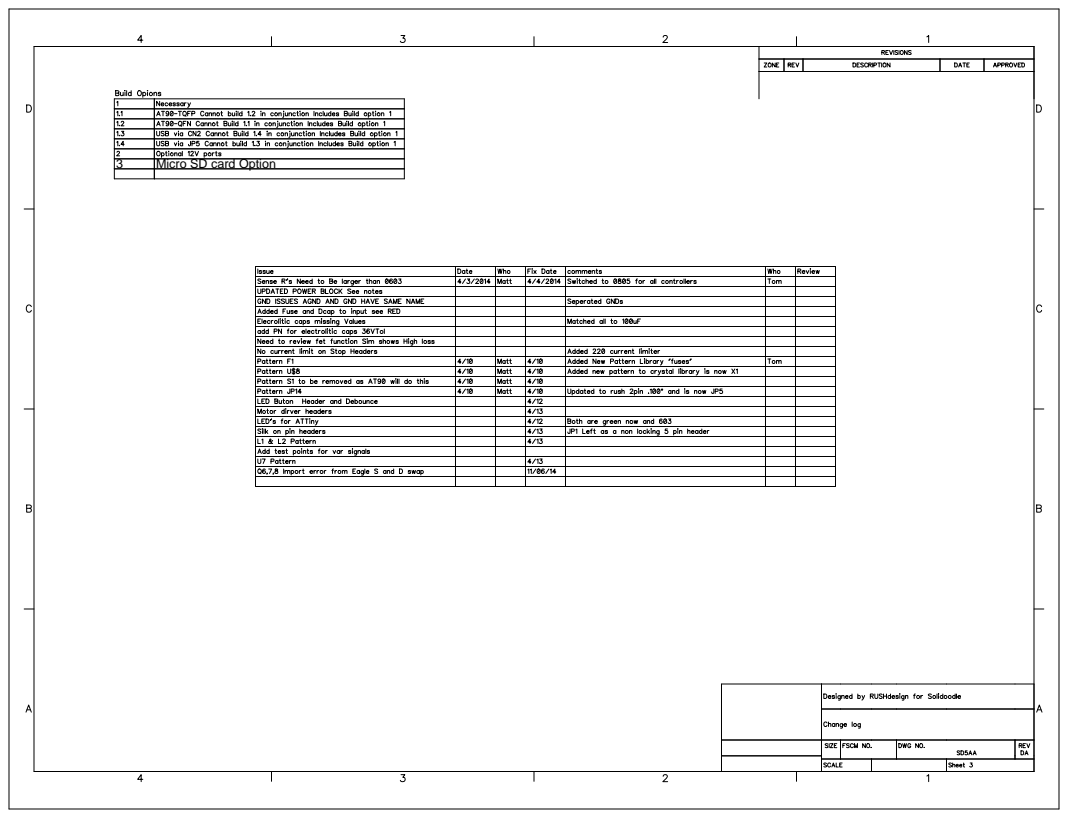
[picture p8: page 3]
Micro SD card Option
