SolidoodleDev/press-pcbs-and-firmware/Solidoodle Press PCB's/LED button PCB/Assembly Drawings.PDF

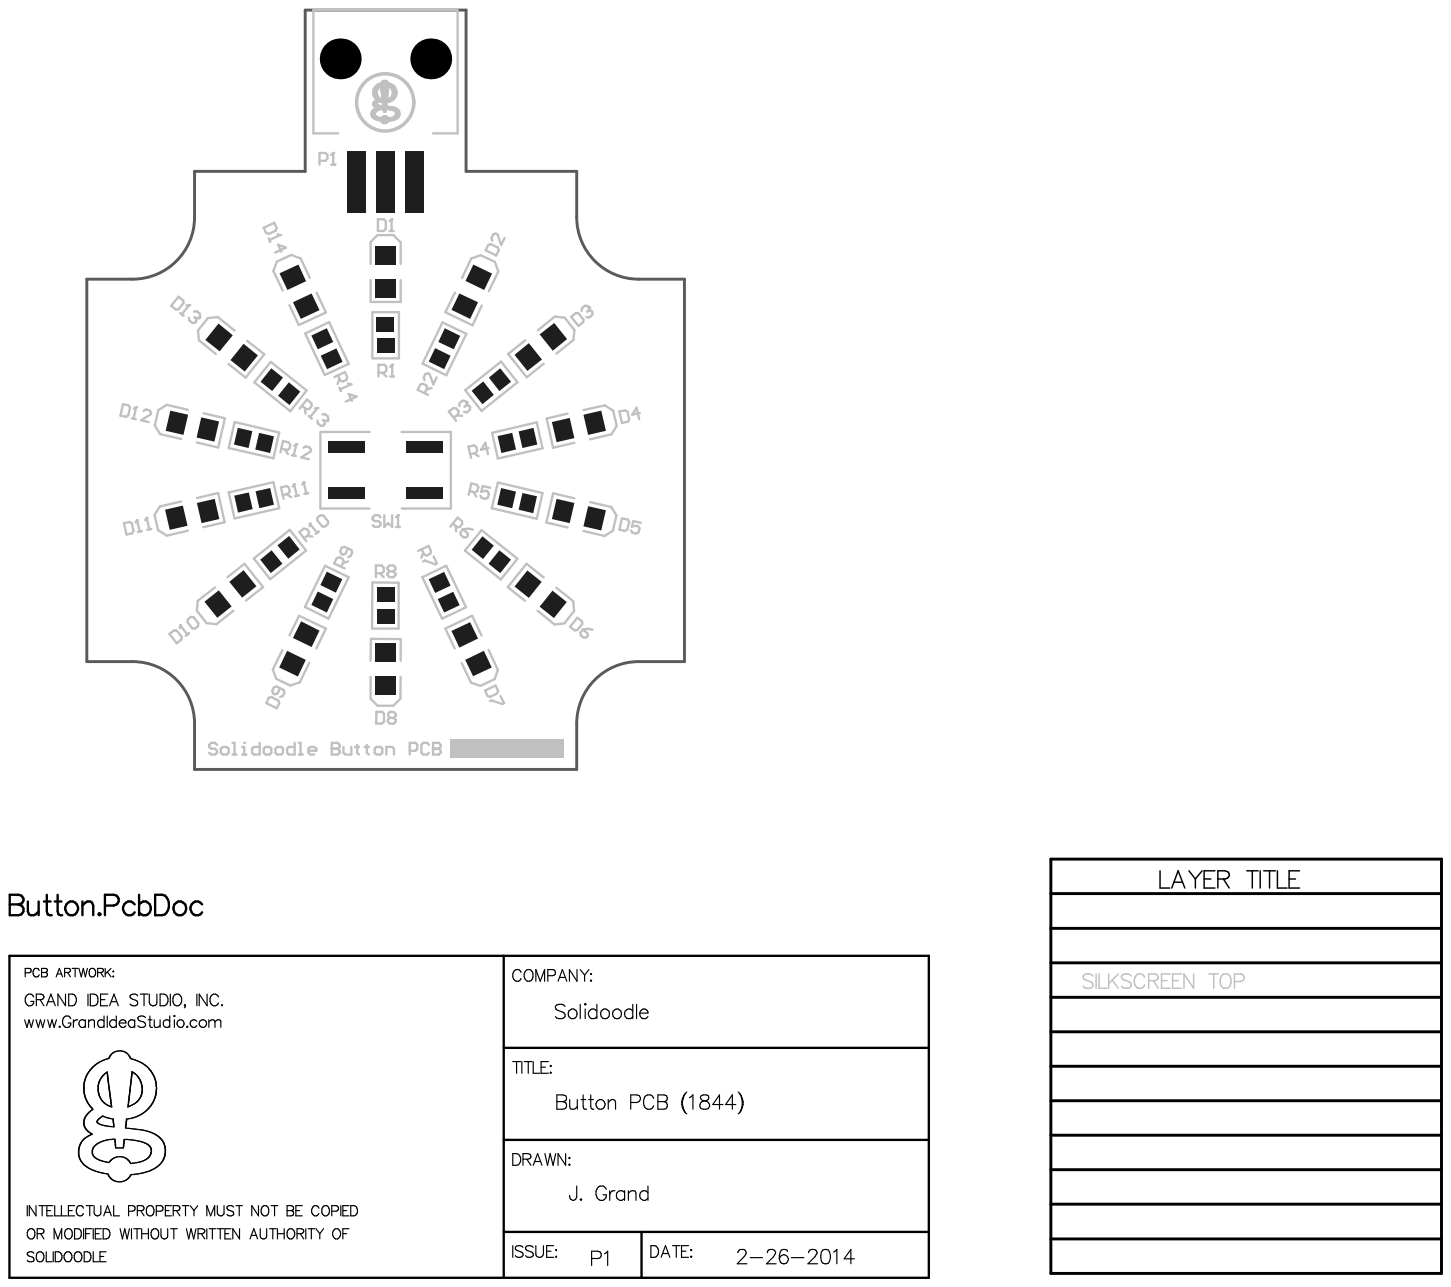
[picture p9: page 1]
