SolidoodleDev/press-pcbs-and-firmware/Solidoodle Press PCB's/LED button PCB/PCB Prints.PDF

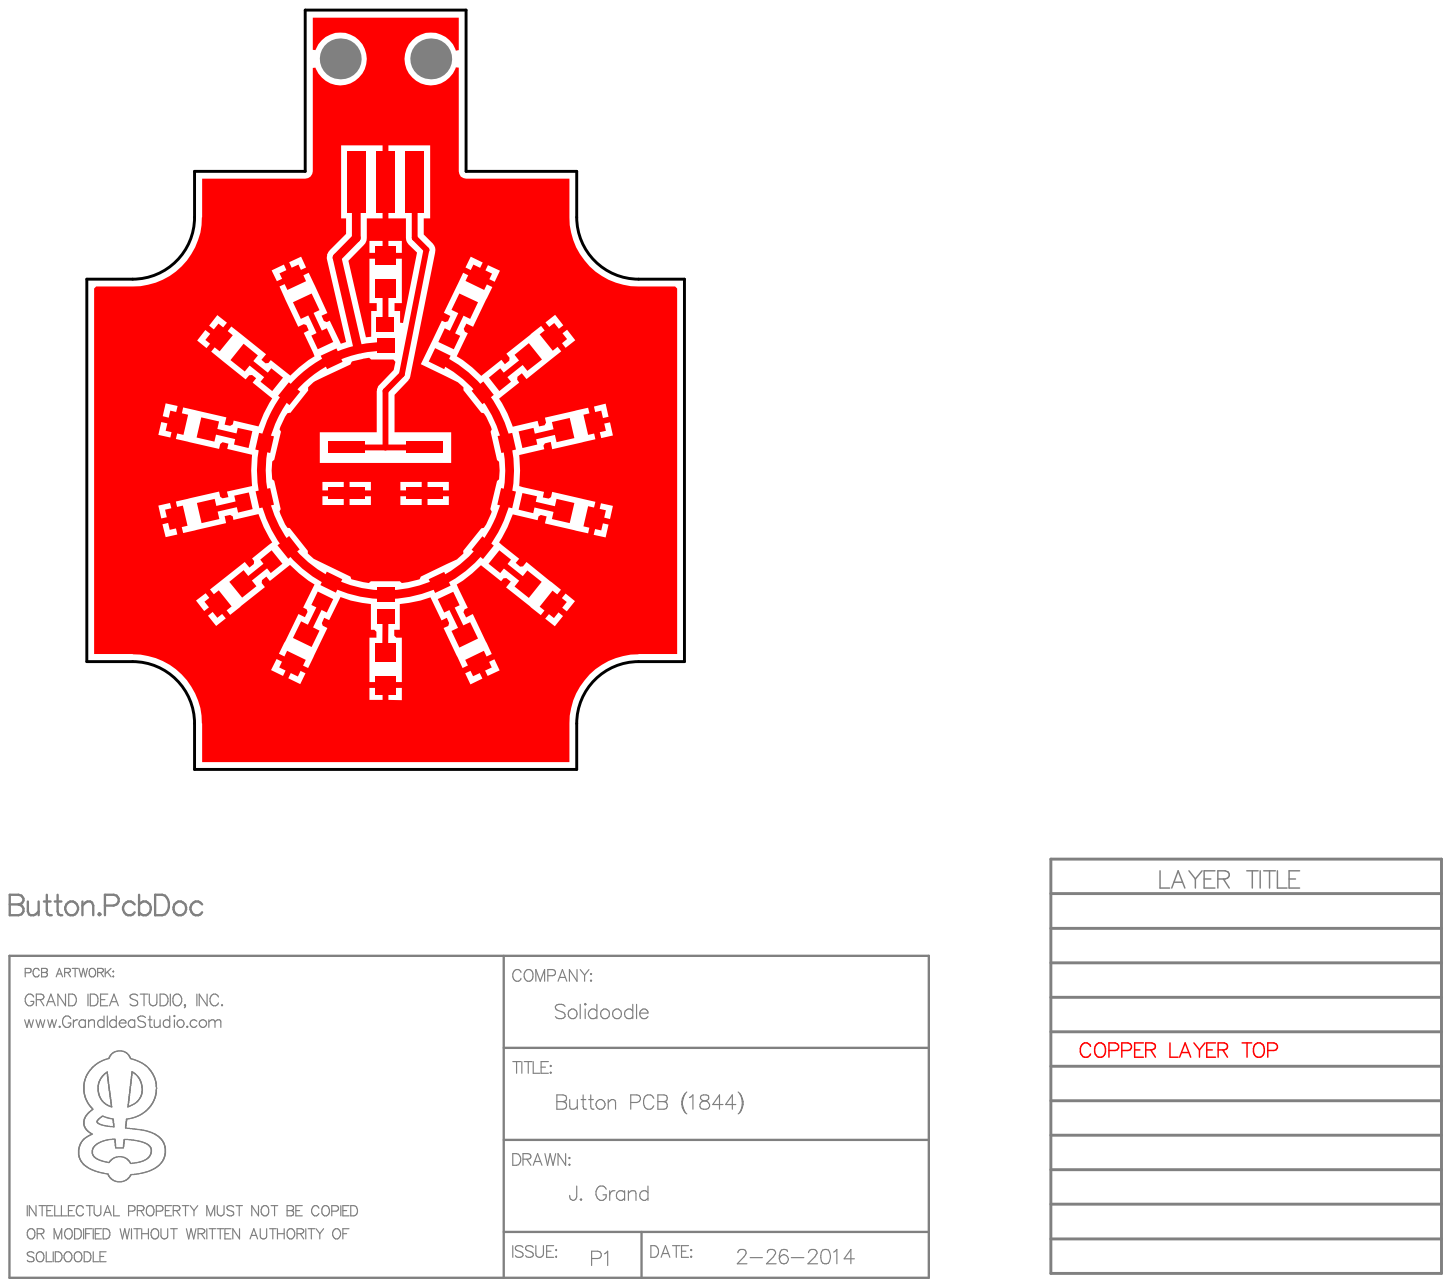
[picture p10: page 1]

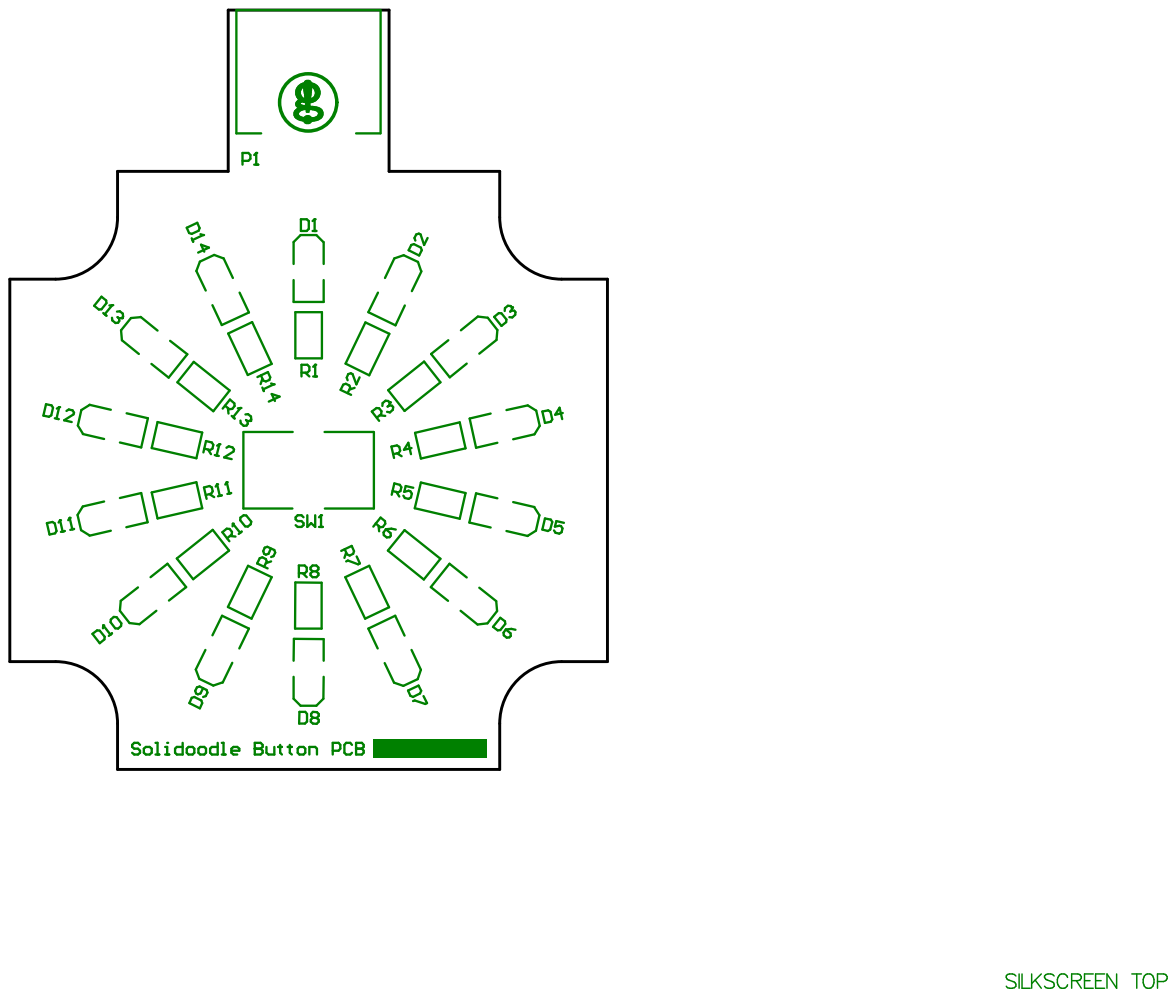
[picture p11: page 2]

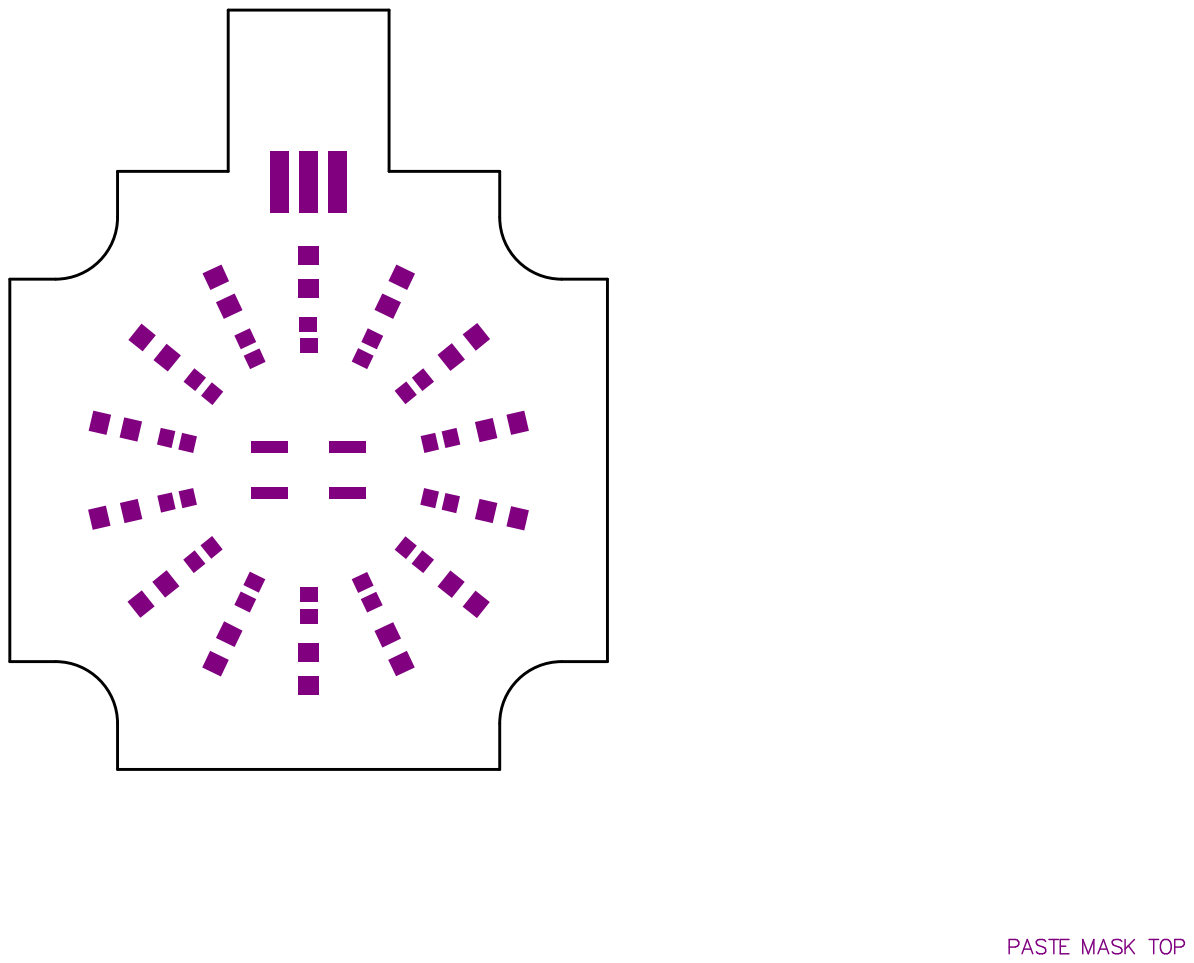
[picture p12: page 3]

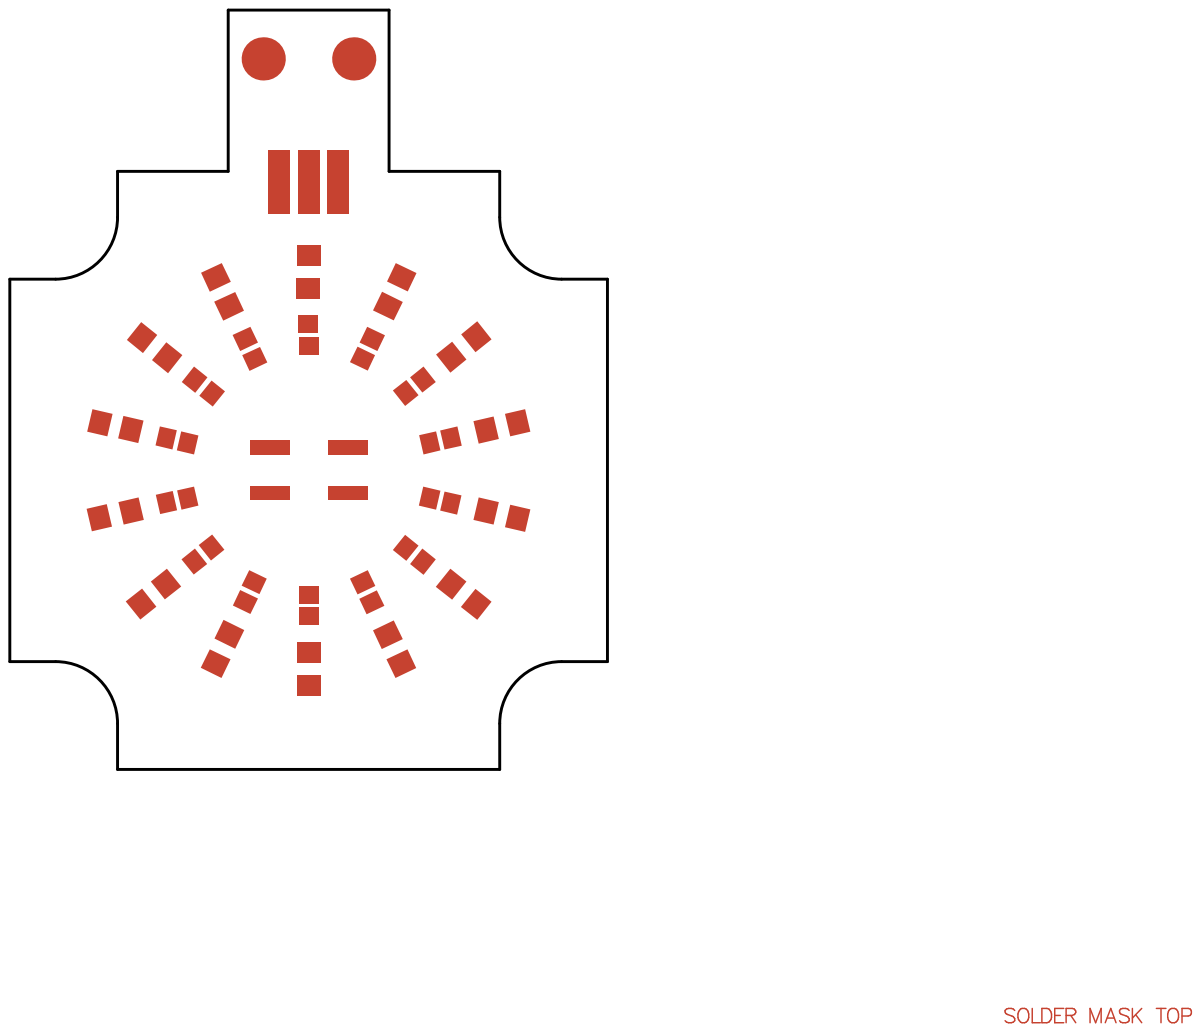
[picture p13: page 4]

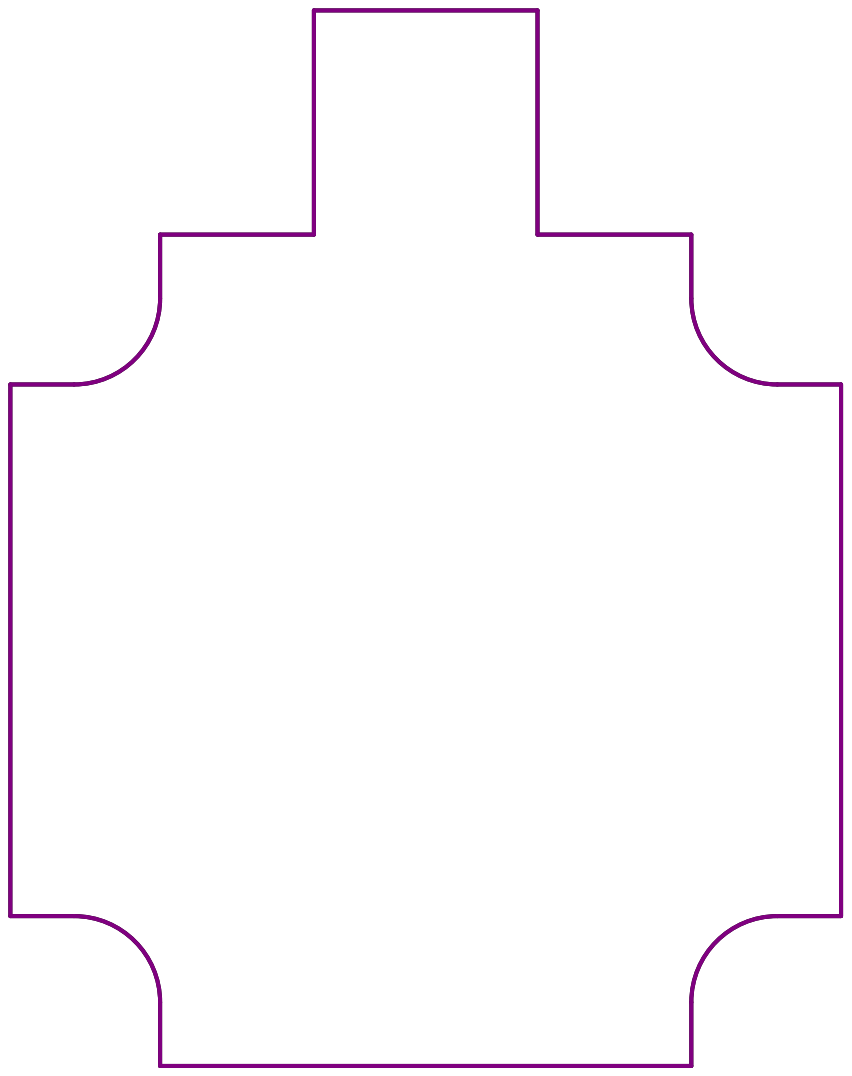
[picture p14: page 5]
