SolidoodleDev/press-pcbs-and-firmware/Solidoodle Press PCB's/SD5AA - Press Motherboard PCB/SD5 AA Final IO UPDATE PG1.pdf

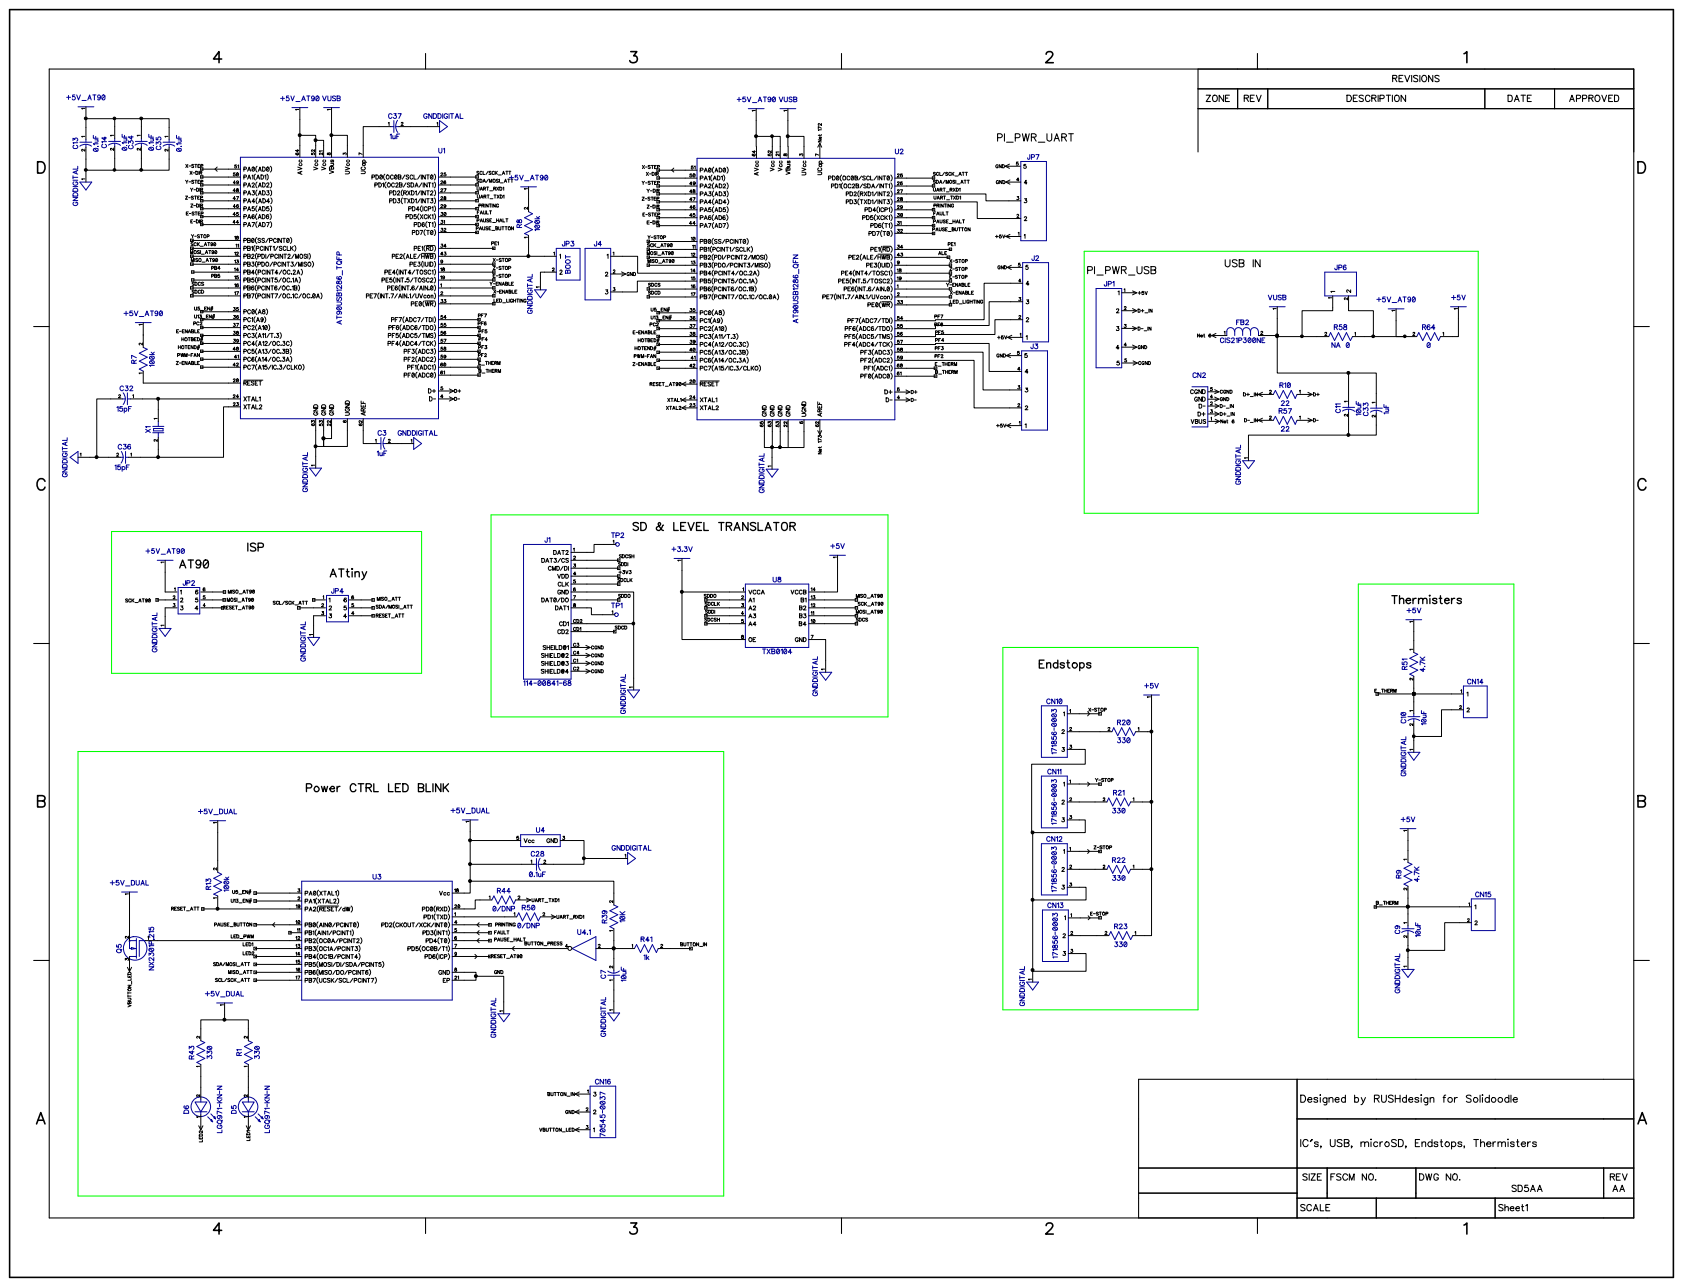
[picture p15: page 1]
