SolidoodleDev/press-pcbs-and-firmware/(list of files, drawings)

Other design files:
Solidoodle Press PCB's/SD5AA - Press Motherboard PCB/SD5 AA Final Silk update.dip
Solidoodle Press PCB's/SD5AA - Press Motherboard PCB/SD5 AA Final.dch
Solidoodle Press PCB's/SD5BA - Press Motherboard PCB/SD5 BA Final Silk update U3 update .dip
Solidoodle Press PCB's/SD5BA - Press Motherboard PCB/SD5 BA Final updated U3 mSD.dch
